razbot2/razbot2_nonros/razbot2_documentation/pictures/2014-11-12 20.54.26.jpg

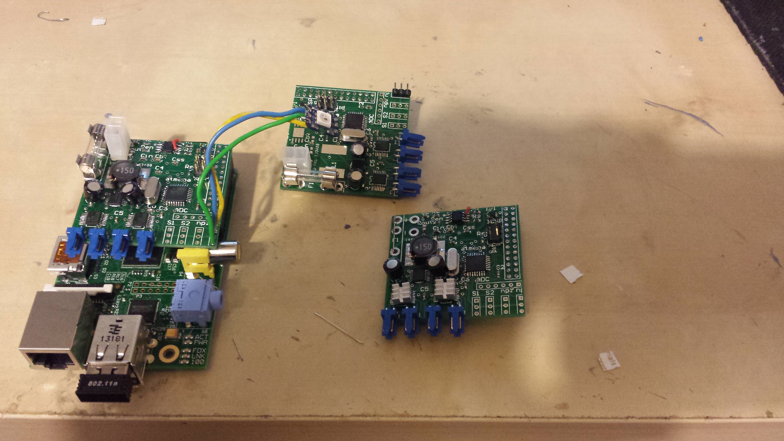
razbot2_documentation/pictures/2014-11-12 20.54.26.jpg
