razbot2/razbot2_nonros/razbot2_documentation/pictures/IMG_1996.JPG

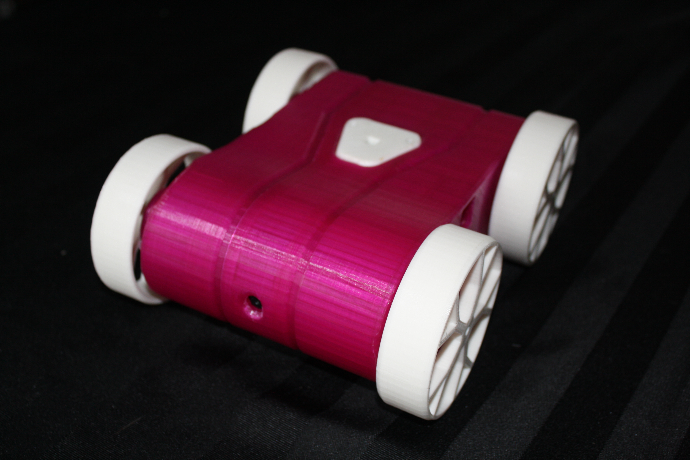
razbot2_documentation/pictures/IMG_1996.JPG
