razbot2/razbot2_nonros/razbot2_documentation/pictures/IMG_1997.JPG

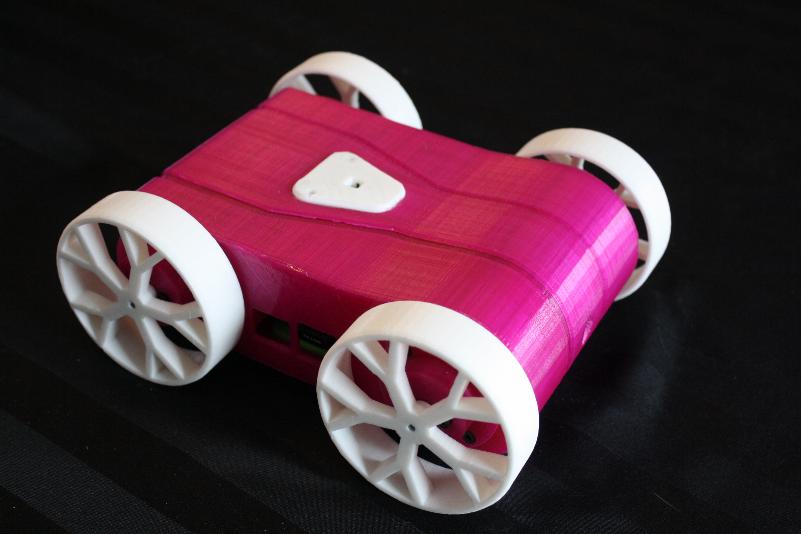
razbot2_documentation/pictures/IMG_1997.JPG
