razbot2/razbot2_nonros/razbot2_documentation/pictures/IMG_1998.JPG

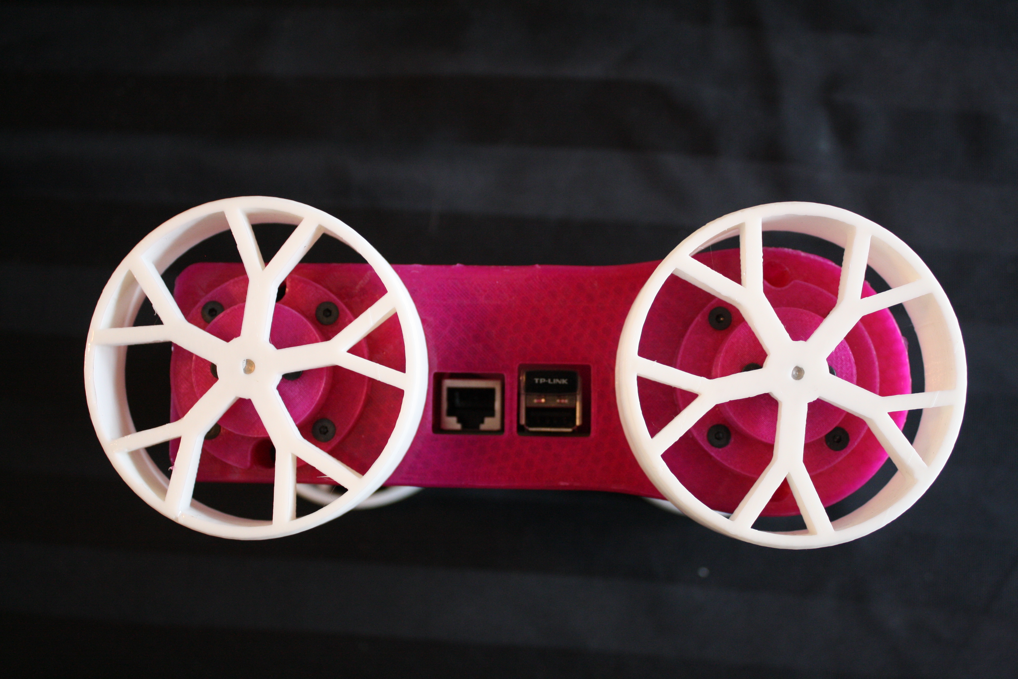
razbot2_documentation/pictures/IMG_1998.JPG
