razbot2/razbot2_nonros/razbot2_documentation/pictures/IMG_1999.JPG

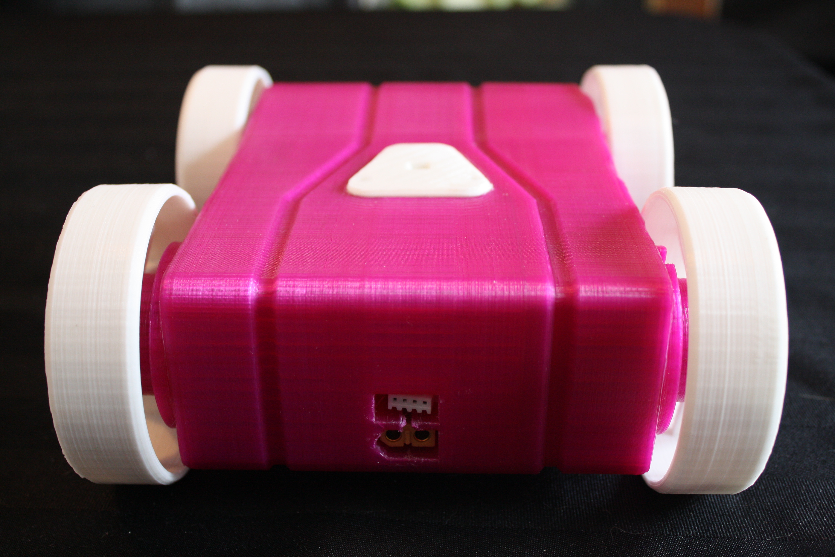
razbot2_documentation/pictures/IMG_1999.JPG
