razbot2/razbot2_nonros/razbot2_documentation/pictures/IMG_2000.JPG

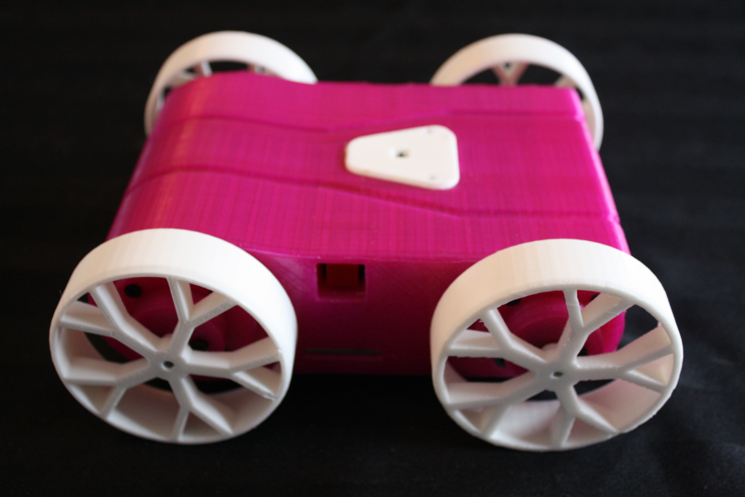
razbot2_documentation/pictures/IMG_2000.JPG
