razbot2/razbot2_nonros/razbot2_documentation/pictures/IMG_2001.JPG

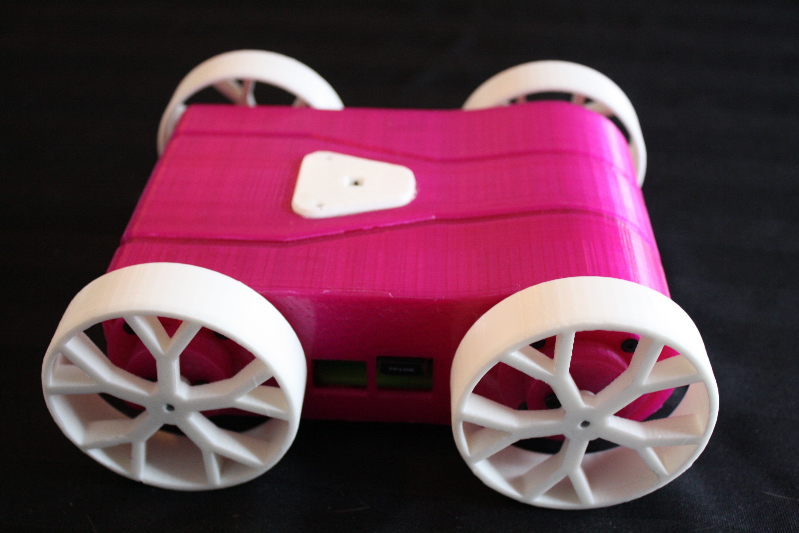
razbot2_documentation/pictures/IMG_2001.JPG
