razbot2/razbot2_nonros/razbot2_documentation/pictures/IMG_2508.JPG

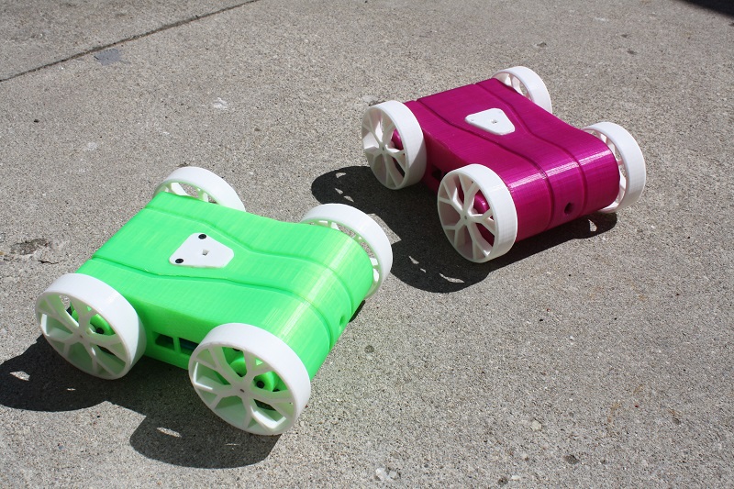
razbot2_documentation/pictures/IMG_2508.JPG
