razbot2/razbot2_nonros/razbot2_documentation/pictures/IMG_2514.JPG

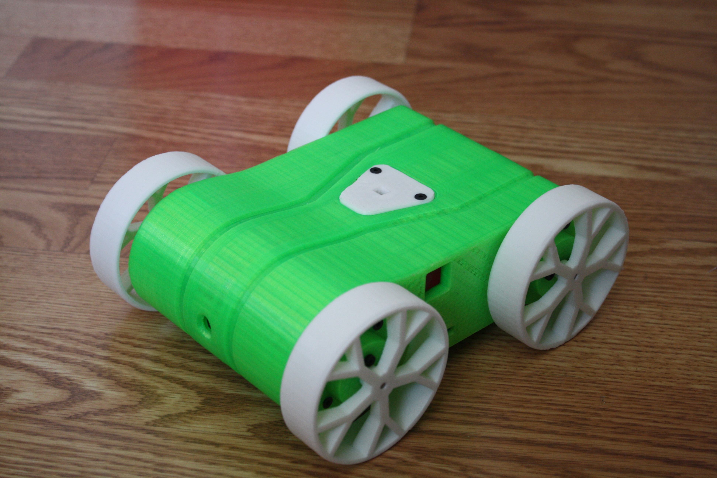
razbot2_documentation/pictures/IMG_2514.JPG
