razbot2/razbot2_nonros/razbot2_documentation/pictures/IMG_2879.JPG

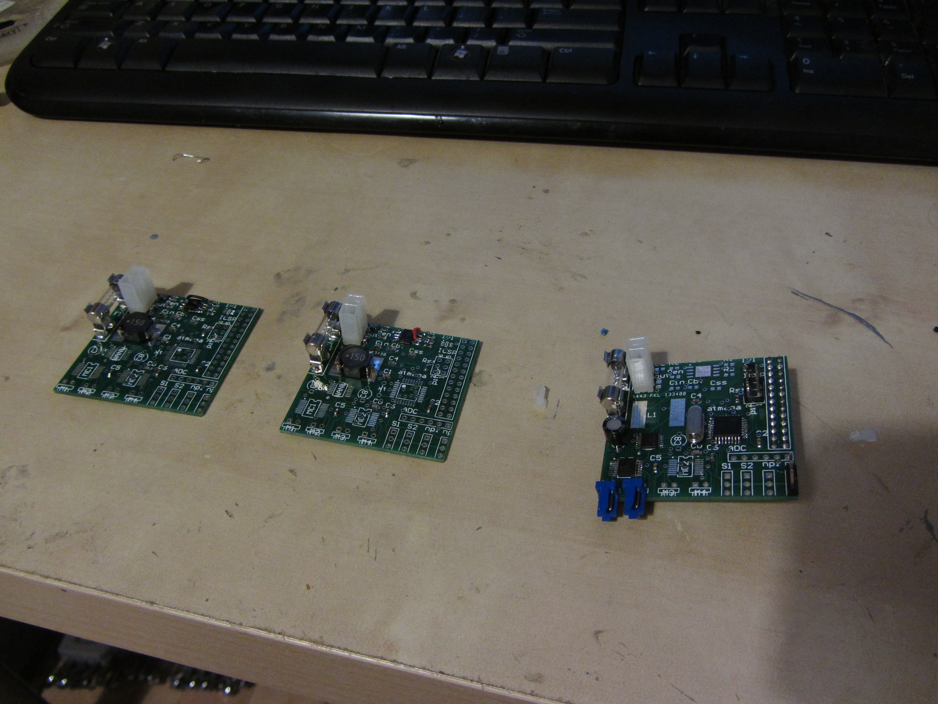
razbot2_documentation/pictures/IMG_2879.JPG
