razbot2/razbot2_nonros/razbot2_documentation/pictures/IMG_3035.JPG

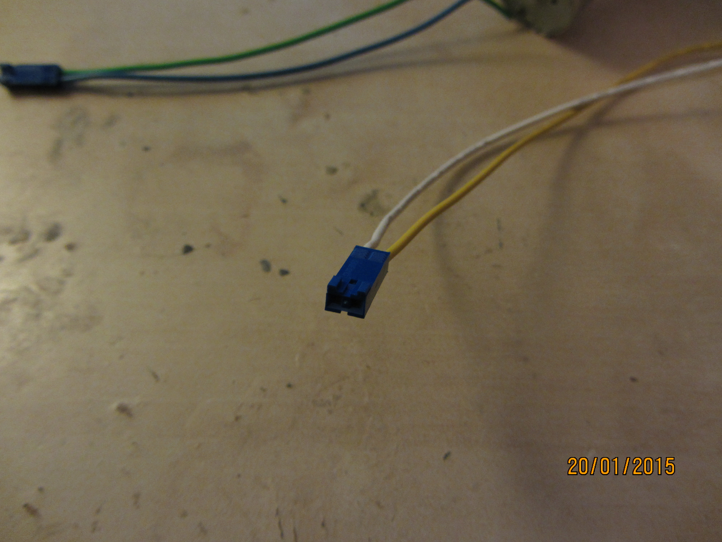
razbot2_documentation/pictures/IMG_3035.JPG
