razbot2/razbot2_nonros/razbot2_documentation/pictures/IMG_3036.JPG

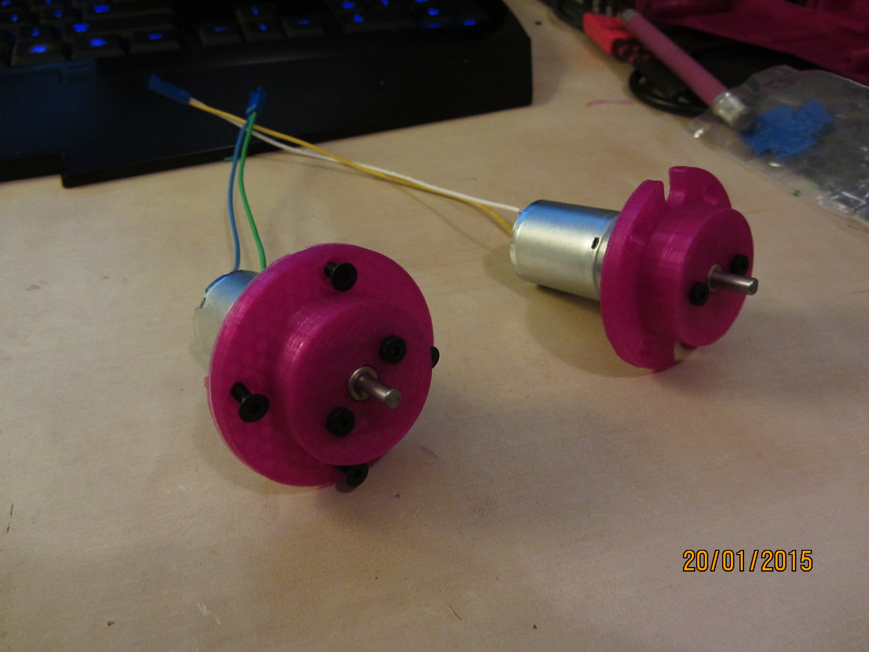
razbot2_documentation/pictures/IMG_3036.JPG
