razbot2/razbot2_nonros/razbot2_documentation/pictures/razbot3.jpg

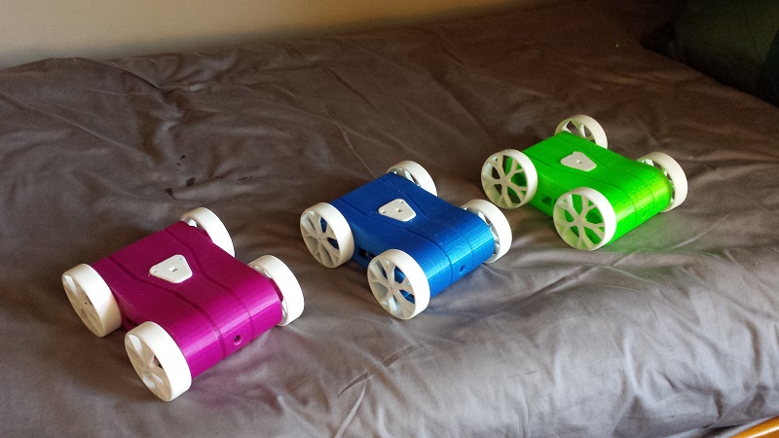
razbot2_documentation/pictures/razbot3.jpg
