razbot2/razbot2_nonros/razbot2_model/raspberry_pi_camera/RasPi_Camera.SLDASM

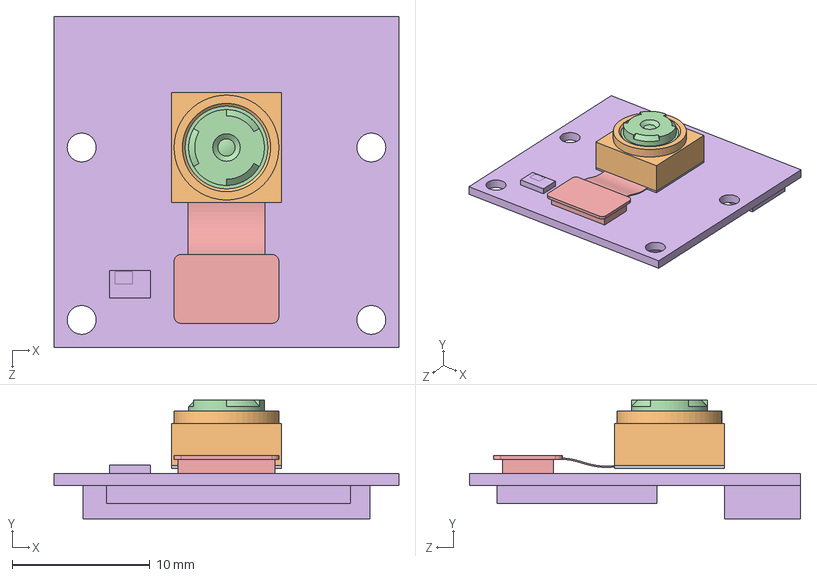
[picture p26: CAD file, 2015-10-27]
razbot2_model/raspberry_pi_camera/RasPi_Camera.SLDASM
25.0 x 8.60 x 24.0 mm
OVA5647
OVA5647_Housing
OVA5647_IR-Glas
OVA5647_Lens
OVA5647_Pigtail
RasPi_Camera_Board
