razbot2/razbot2_nonros/razbot2_model/raspberry_pi_camera/OVA5647.SLDASM

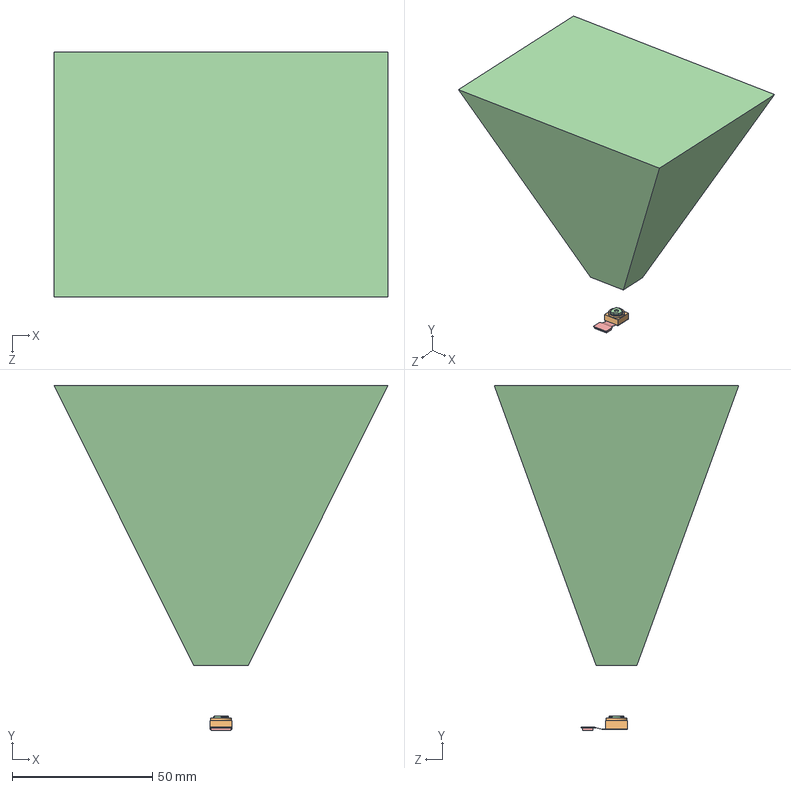
[picture p27: CAD file, 2015-10-27]
razbot2_model/raspberry_pi_camera/OVA5647.SLDASM
119.2 x 123.2 x 87.4 mm
OVA5647
OVA5647_Housing
OVA5647_IR-Glas
OVA5647_Lens
OVA5647_Pigtail
