razbot2/razbot2_nonros/razbot2_model/Side_Assem_Right.SLDASM

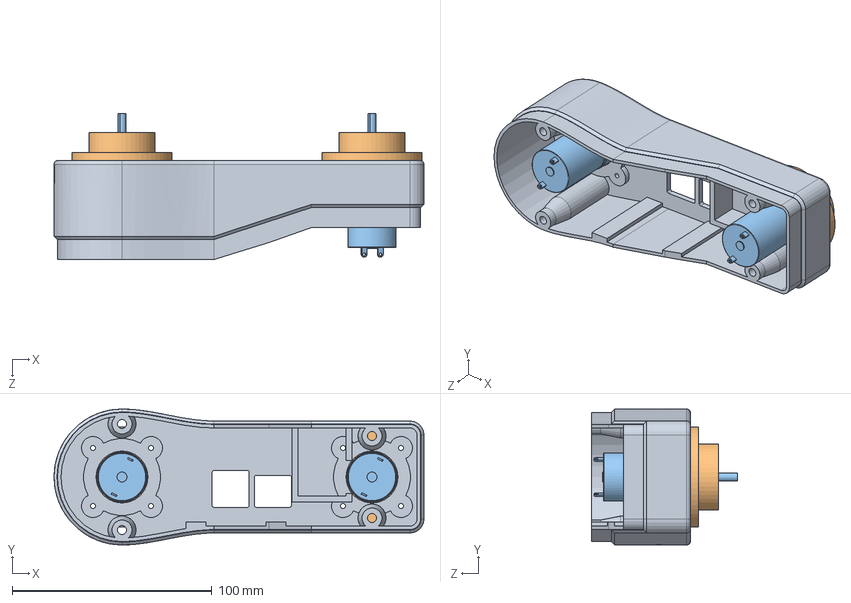
[picture p28: CAD file, 2015-10-27]
razbot2_model/Side_Assem_Right.SLDASM
185.0 x 68.0 x 73.0 mm
Side_Right
motor_holder_r0.4 x 2
Motor_25x55_gear x 2
