razbot2/razbot2_nonros/razbot2_model/Side_Assem_Left.SLDASM

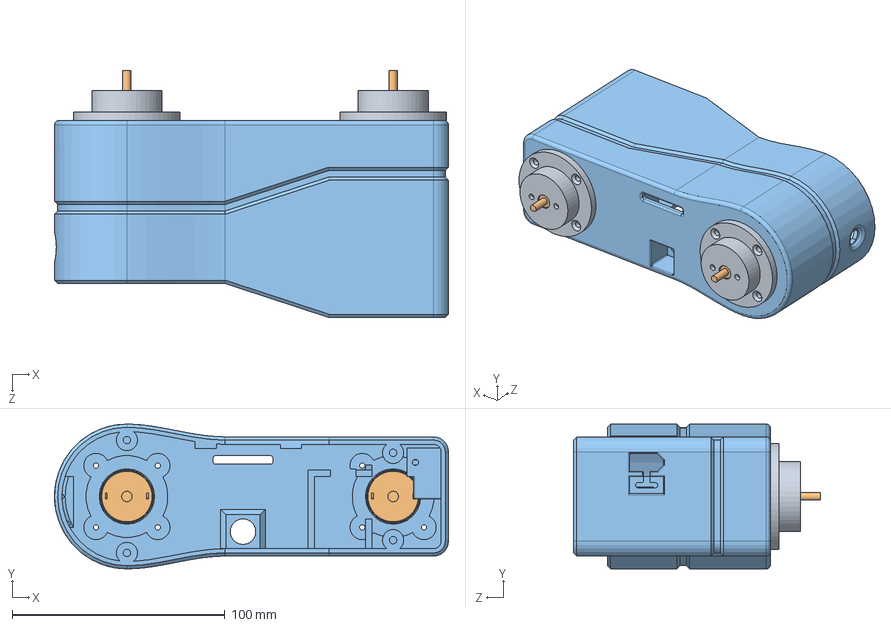
[picture p30: CAD file, 2015-10-27]
razbot2_model/Side_Assem_Left.SLDASM
185.0 x 68.0 x 116.0 mm
motor_holder_r0.4 x 2
Motor_25x55_gear x 2
Side_Left
