razbot2/razbot2_nonros/razbot2_model/Motor_Assem.SLDASM

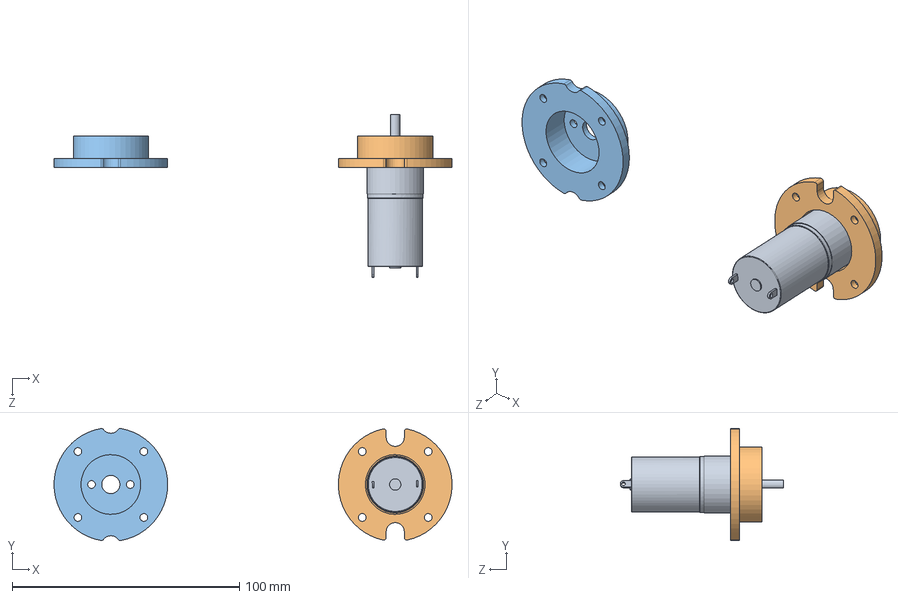
[picture p33: CAD file, 2015-10-27]
razbot2_model/Motor_Assem.SLDASM
175.0 x 49.3 x 71.9 mm
25x55_gear_motor
motor_holder_r0.5
