razbot2/razbot2_nonros/razbot2_model/raspberry_pi/raspberry_pi__micro_USB.SLDASM

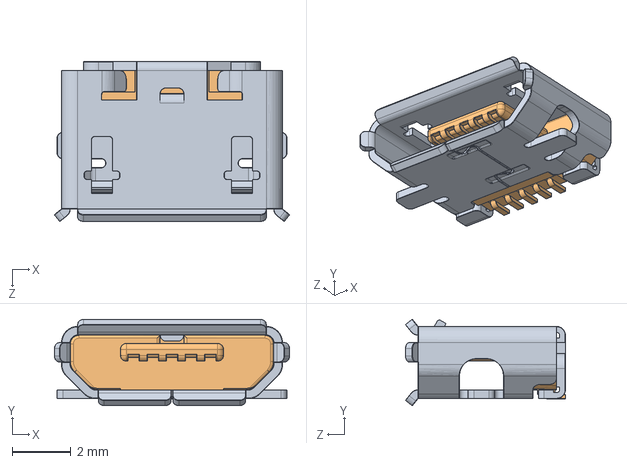
[picture p35: CAD file, 2015-10-27]
razbot2_model/raspberry_pi/raspberry_pi__micro_USB.SLDASM
7.97 x 2.92 x 5.43 mm
raspberry_pi__micro_USB_cover
raspberry_pi__micro_USB_contacts
