razbot2/razbot2_nonros/razbot2_model/raspberry_pi/raspberry_pi__USB_x2.SLDASM

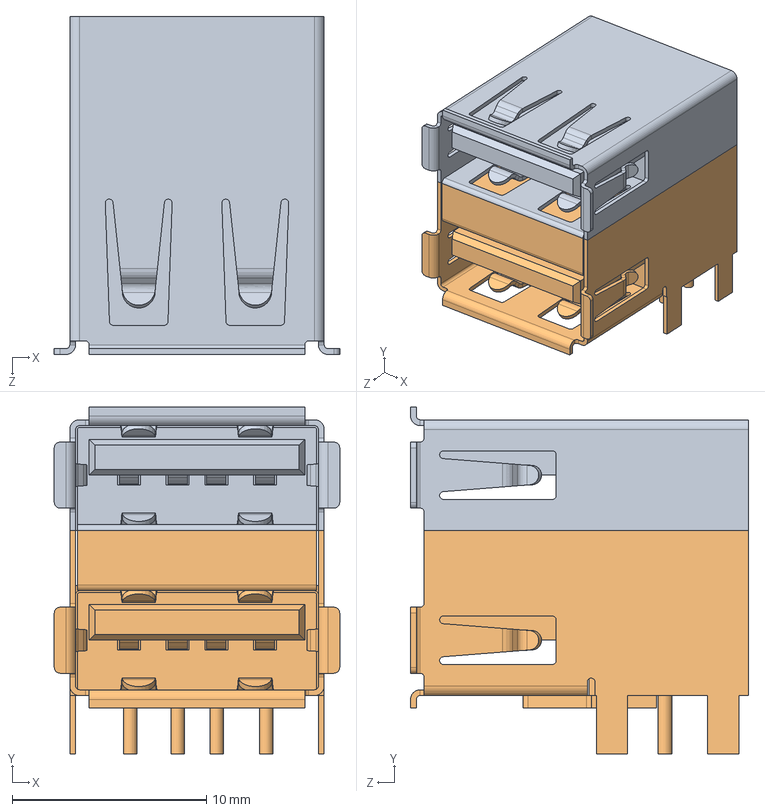
[picture p37: CAD file, 2015-10-27]
razbot2_model/raspberry_pi/raspberry_pi__USB_x2.SLDASM
14.7 x 17.9 x 17.4 mm
raspberry_pi__USB_x2_part1
raspberry_pi__USB_x2_part2
