razbot2/razbot2_nonros/razbot2_model/gazeboSTL/wheel_3.STL

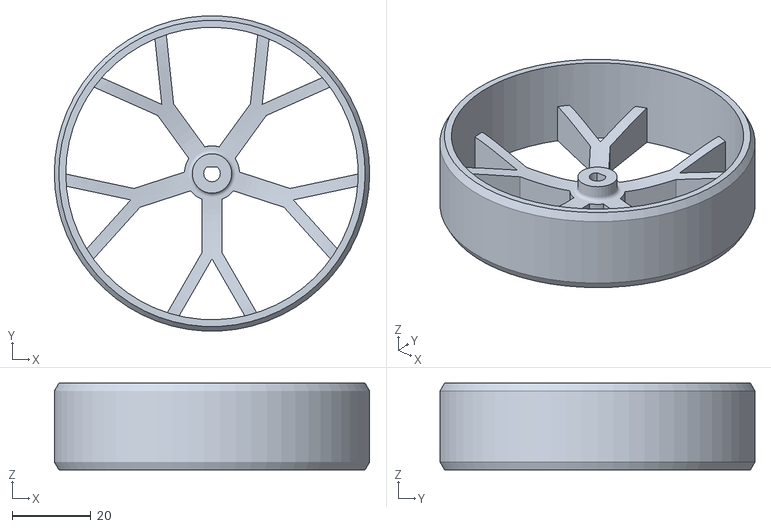
[picture p40: CAD file, 2015-10-27]
razbot2_model/gazeboSTL/wheel_3.STL
80.0 x 79.9 x 22.0
