razbot2/razbot2_nonros/razbot2_model/PiTrayB+.SLDPRT

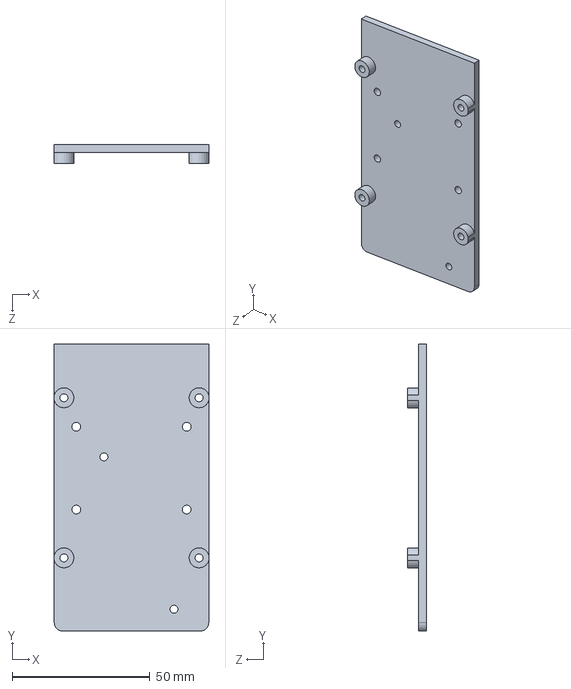
[picture p41: CAD file, 2015-10-27]
razbot2_model/PiTrayB+.SLDPRT
56.0 x 104.0 x 7.00 mm
