razbot2/razbot2_nonros/razbot2_model/raspberry_pi/raspberry_pi__QFN64-2.SLDPRT

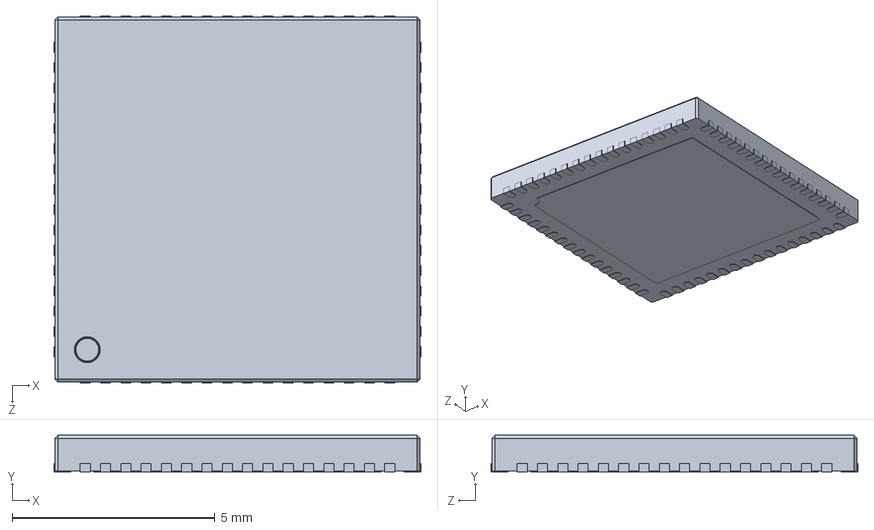
[picture p42: CAD file, 2015-10-27]
razbot2_model/raspberry_pi/raspberry_pi__QFN64-2.SLDPRT
9.04 x 0.9 x 9.04 mm
