razbot2/razbot2_nonros/razbot2_model/raspberry_pi_acc/USBwifi.SLDPRT

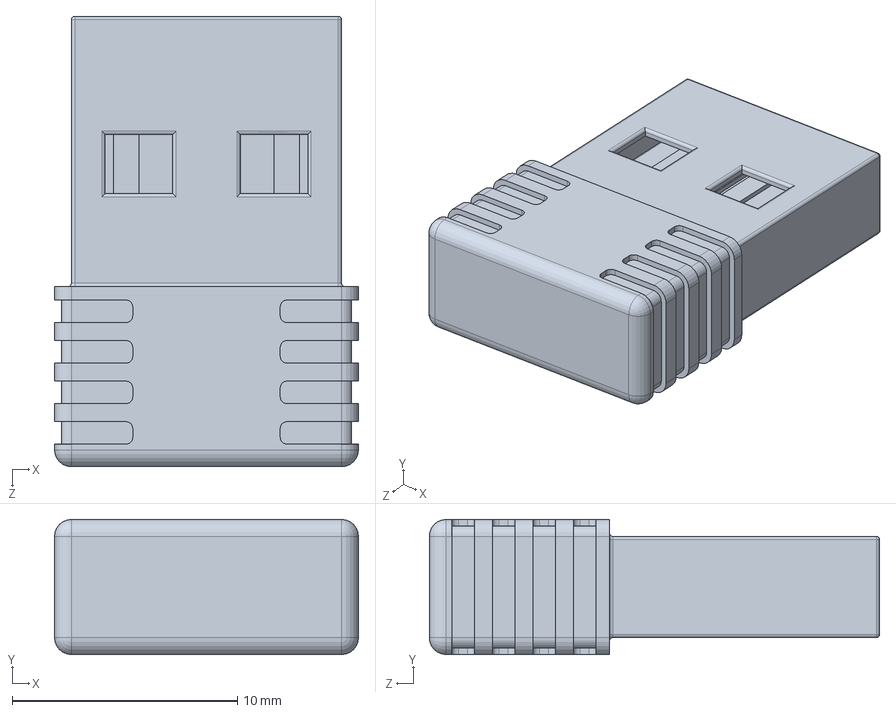
[picture p43: CAD file, 2015-10-27]
razbot2_model/raspberry_pi_acc/USBwifi.SLDPRT
13.5 x 6.00 x 20.0 mm
