razbot2/razbot2_nonros/razbot2_model/raspberry_pi_camera/OVA5647_Lens.SLDPRT

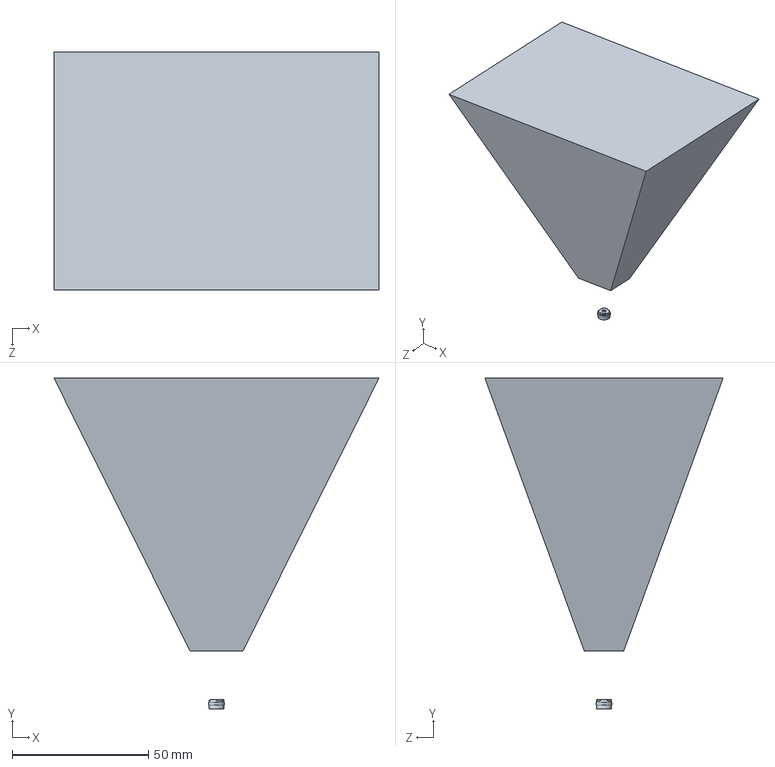
[picture p44: CAD file, 2015-10-27]
razbot2_model/raspberry_pi_camera/OVA5647_Lens.SLDPRT
119.2 x 121.3 x 87.4 mm
