razbot2/razbot2_nonros/razbot2_model/razbot2_mods/Razbot Mounting Plate.STL

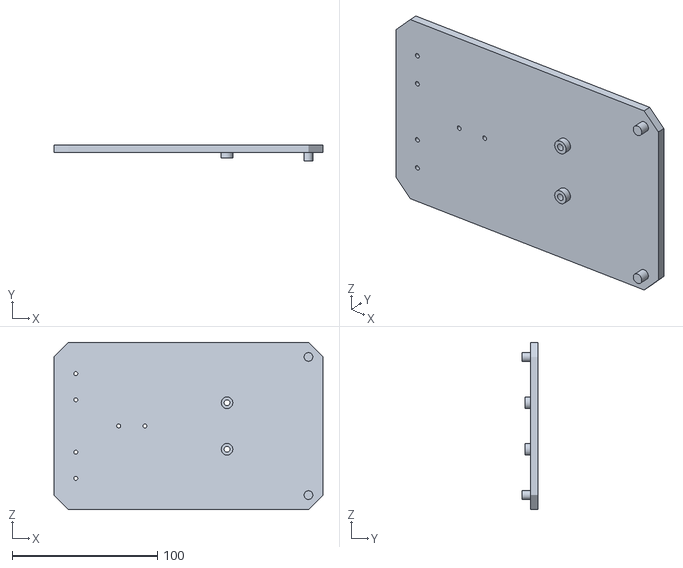
[picture p45: CAD file, 2015-12-04]
razbot2_model/razbot2_mods/Razbot Mounting Plate.STL
185.0 x 11.0 x 115.0
