razbot2/razbot2_nonros/razbot2_model/razbot_STL/Top_Plate.stl

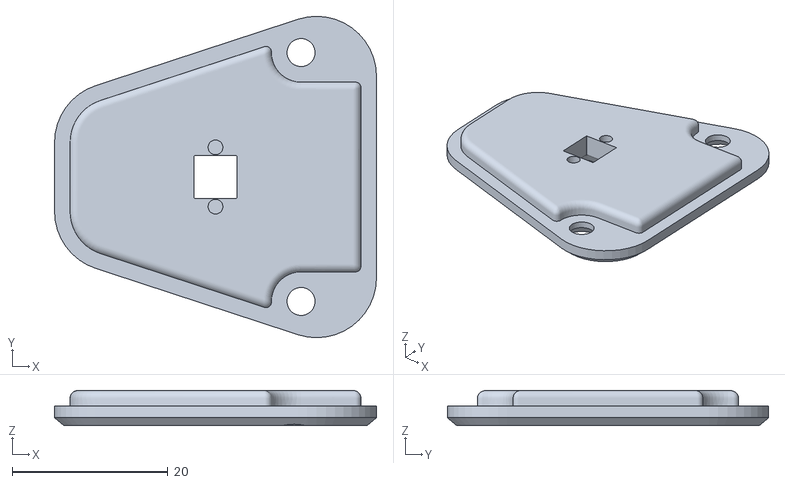
[picture p46: CAD file, 2015-10-27]
razbot2_model/razbot_STL/Top_Plate.stl
41.4 x 41.3 x 4.50
