razbot2/razbot2_nonros/razbot2_model/motor_holder_r0.5.SLDPRT

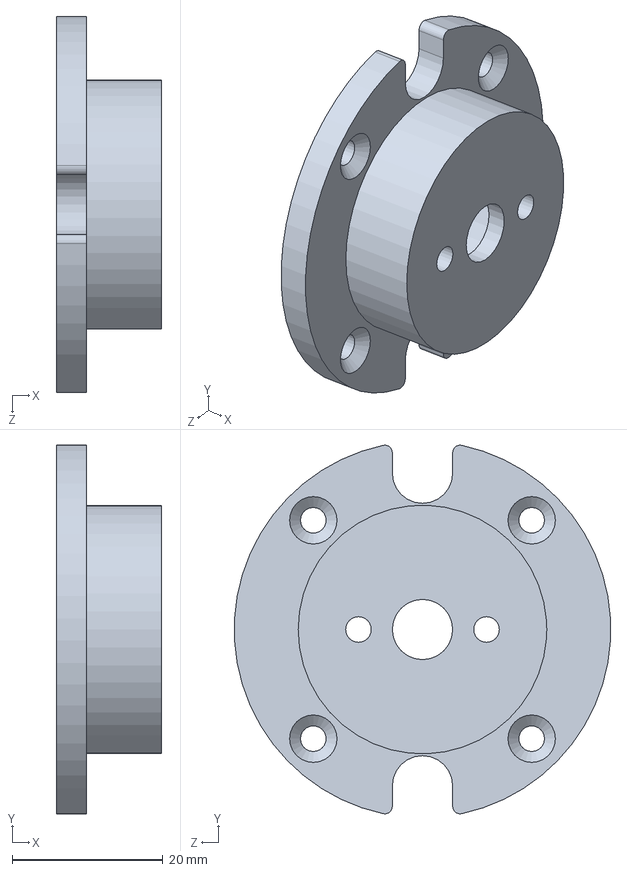
[picture p47: CAD file, 2015-10-27]
razbot2_model/motor_holder_r0.5.SLDPRT
14.0 x 48.9 x 49.9 mm
