razbot2/razbot2_nonros/razbot2_model/raspberry_pi/raspberry_pi__1812.SLDPRT

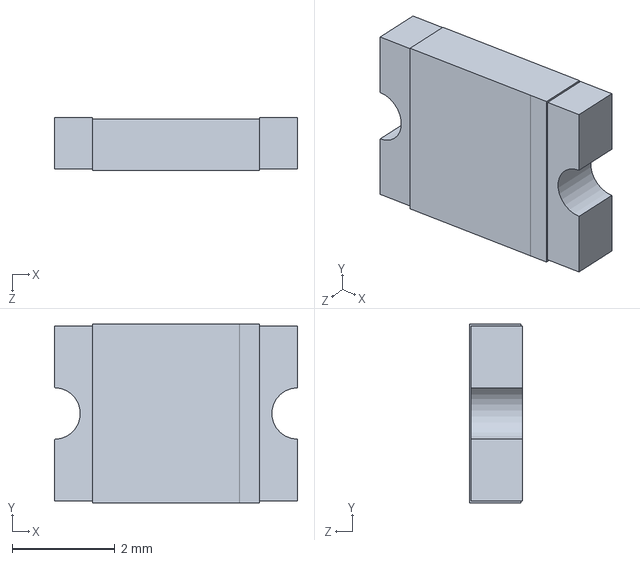
[picture p48: CAD file, 2015-10-27]
razbot2_model/raspberry_pi/raspberry_pi__1812.SLDPRT
4.74 x 3.48 x 1.03 mm
