razbot2/razbot2_nonros/razbot2_model/raspberry_pi_camera/OVA5647_IR-Glas.SLDPRT

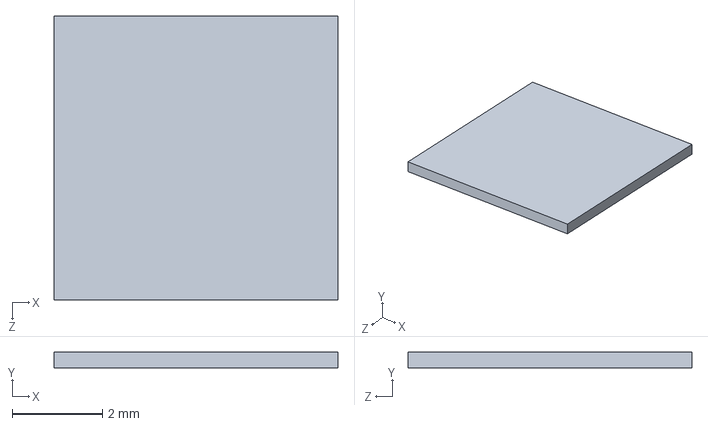
[picture p49: CAD file, 2015-10-27]
razbot2_model/raspberry_pi_camera/OVA5647_IR-Glas.SLDPRT
6.30 x 0.35 x 6.30 mm
