razbot2/razbot2_nonros/razbot2_model/razbot2_mods/GripperGear.stl

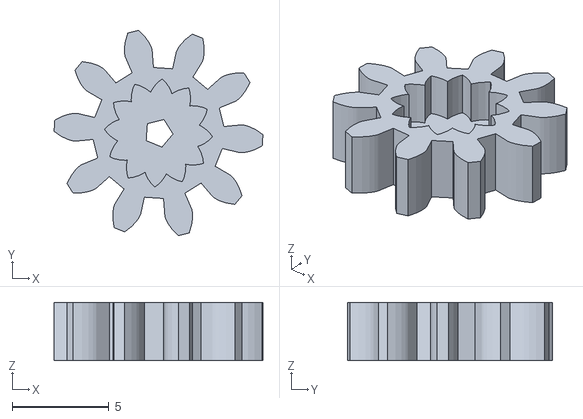
[picture p50: CAD file, 2015-12-04]
razbot2_model/razbot2_mods/GripperGear.stl
10.8 x 10.6 x 3.00
