razbot2/razbot2_nonros/razbot2_model/Motor_25x55_gear.SLDPRT

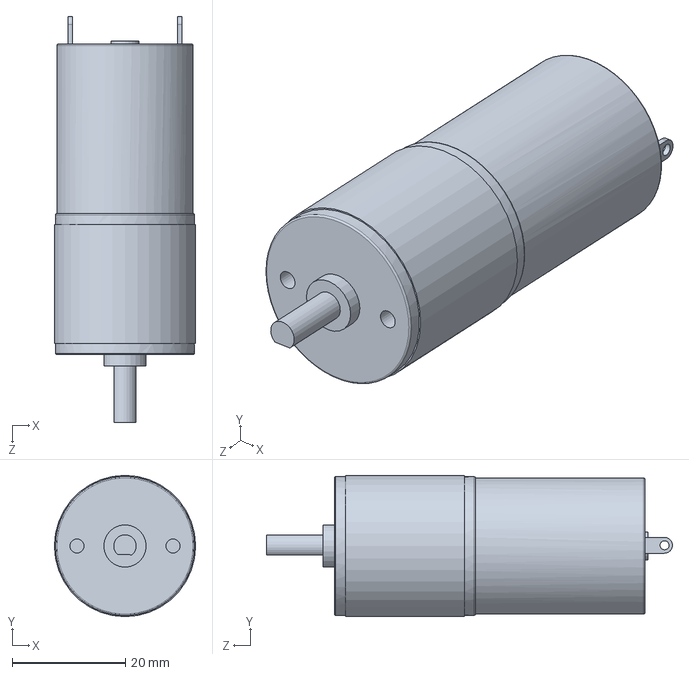
[picture p51: CAD file, 2015-10-27]
razbot2_model/Motor_25x55_gear.SLDPRT
25.0 x 25.0 x 71.9 mm
