razbot2/razbot2_nonros/razbot2_model/raspberry_pi/raspberry_pi__SD_reader_pin4.SLDPRT

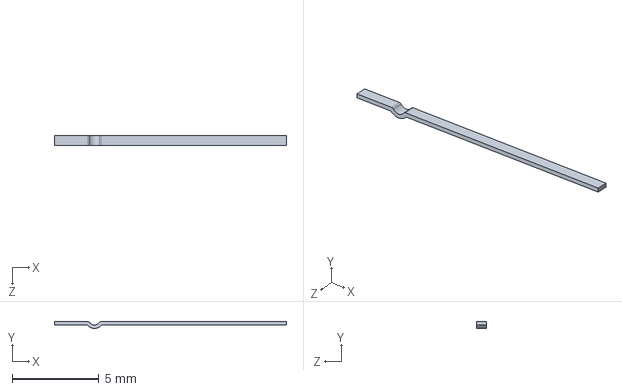
[picture p52: CAD file, 2015-10-27]
razbot2_model/raspberry_pi/raspberry_pi__SD_reader_pin4.SLDPRT
13.3 x 0.396 x 0.55 mm
