razbot2/razbot2_nonros/razbot2_model/razbot2_mods/Razbot_2 Arm Base.STL

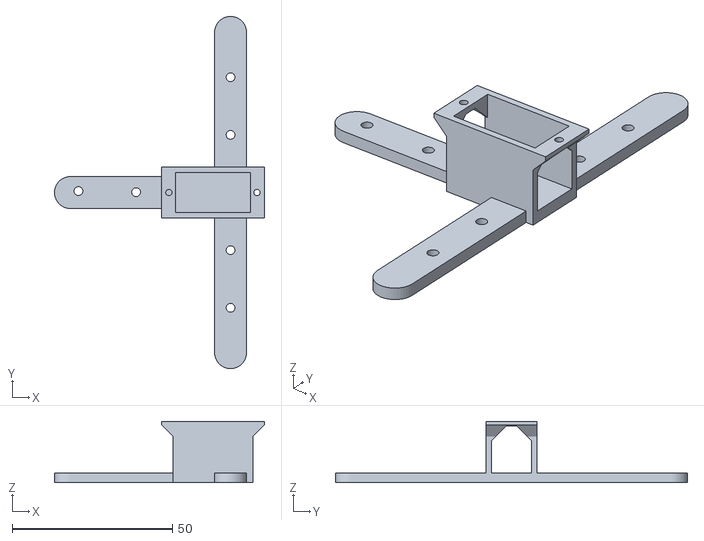
[picture p53: CAD file, 2015-12-04]
razbot2_model/razbot2_mods/Razbot_2 Arm Base.STL
65.6 x 110.0 x 19.2
