razbot2/razbot2_nonros/razbot2_model/razbot_STL/L_motor_holder.STL

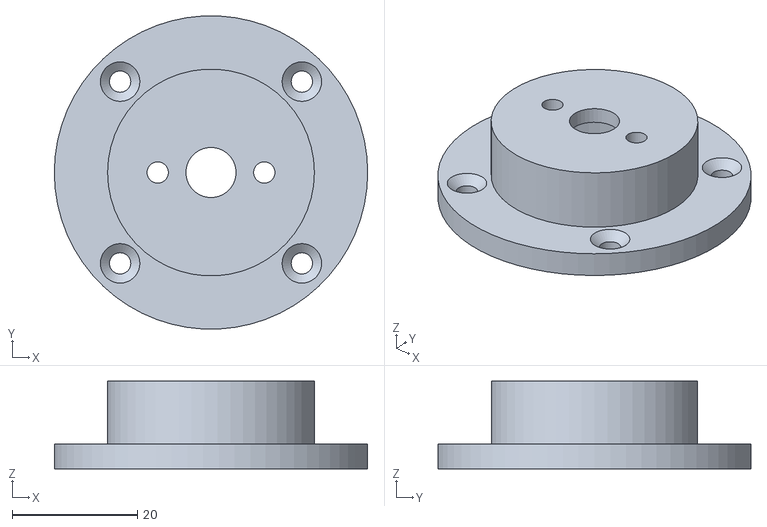
[picture p54: CAD file, 2015-10-27]
razbot2_model/razbot_STL/L_motor_holder.STL
50.0 x 49.9 x 14.0
