razbot2/razbot2_nonros/razbot2_model/raspberry_pi/raspberry_pi__15_pin_FFC_Connector_pins.SLDPRT

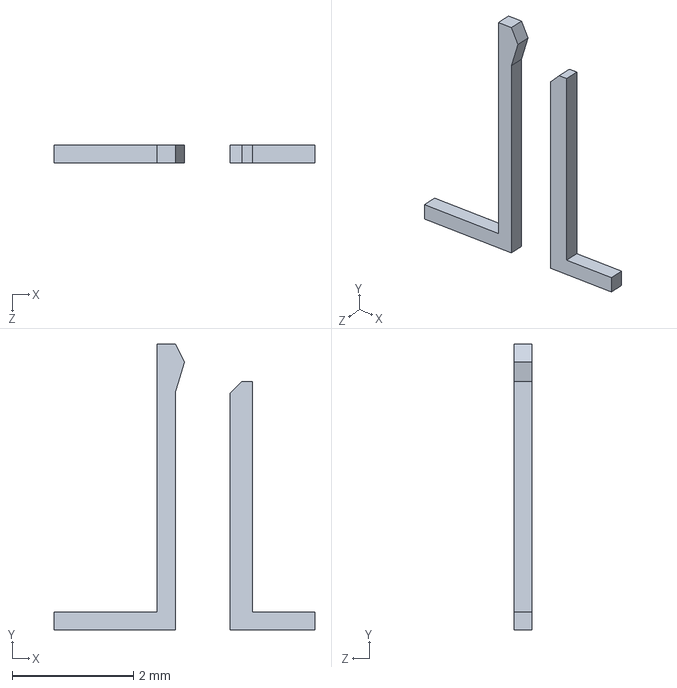
[picture p55: CAD file, 2015-10-27]
razbot2_model/raspberry_pi/raspberry_pi__15_pin_FFC_Connector_pins.SLDPRT
4.30 x 4.71 x 0.3 mm
