razbot2/razbot2_nonros/razbot2_model/razbot2_mods/ArmSpring.stl

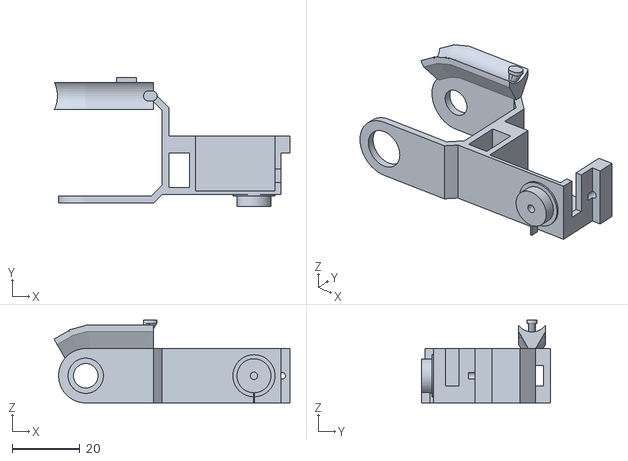
[picture p56: CAD file, 2015-12-04]
razbot2_model/razbot2_mods/ArmSpring.stl
69.4 x 37.9 x 24.4
