razbot2/razbot2_nonros/razbot2_model/raspberry_pi/raspberry_pi__HDMI_socket_small_pin.SLDPRT

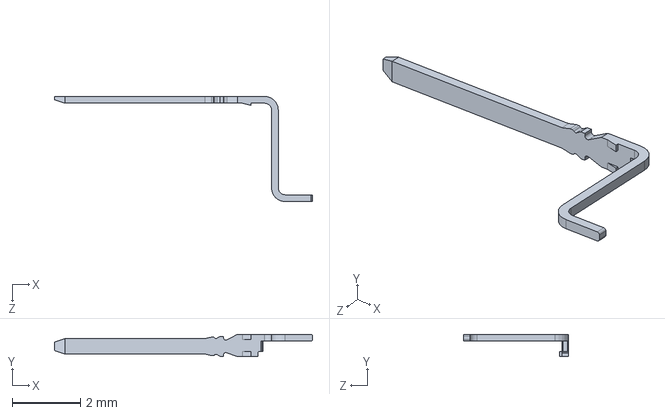
[picture p58: CAD file, 2015-10-27]
razbot2_model/raspberry_pi/raspberry_pi__HDMI_socket_small_pin.SLDPRT
7.55 x 0.65 x 3.08 mm
