razbot2/razbot2_nonros/razbot2_model/raspberry_pi_camera/RasPi_Camera_Board.SLDPRT

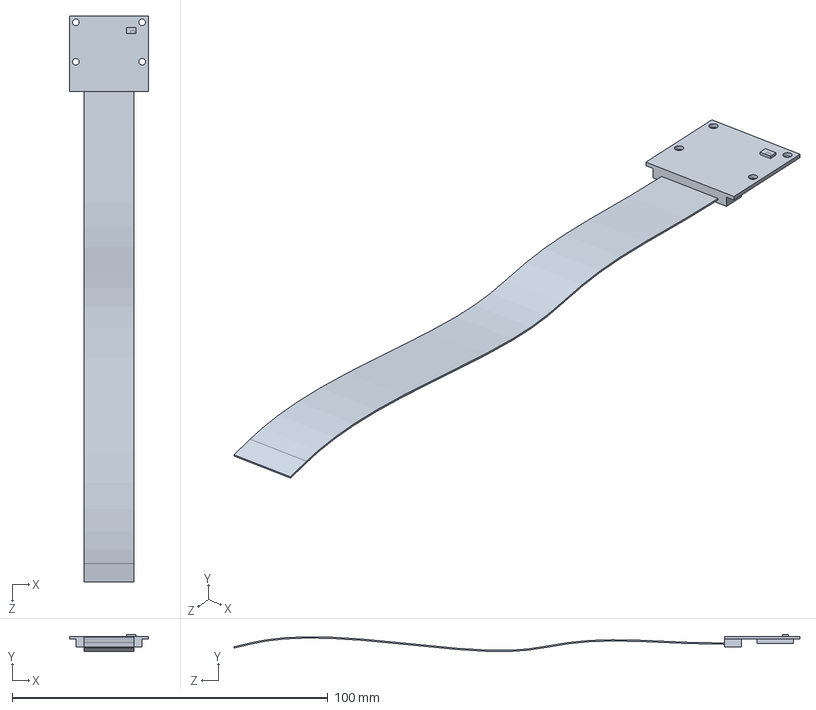
[picture p59: CAD file, 2015-10-27]
razbot2_model/raspberry_pi_camera/RasPi_Camera_Board.SLDPRT
25.0 x 5.39 x 179.3 mm
