razbot2/razbot2_nonros/razbot2_model/razbot2_mods/FrontPlate.stl

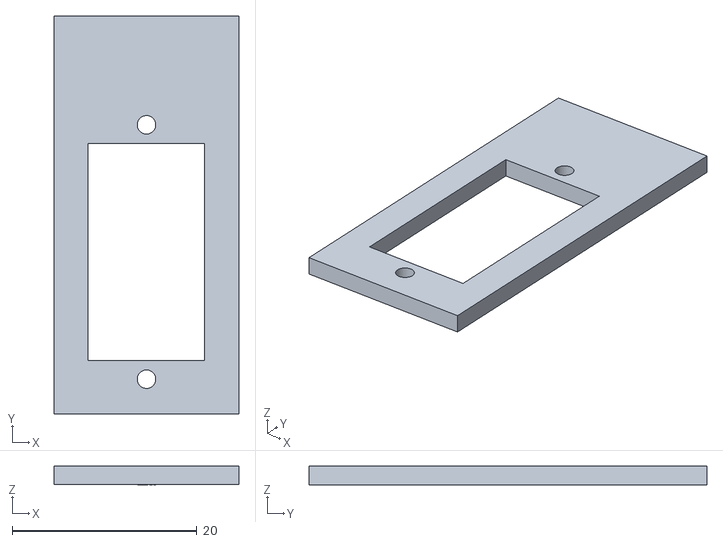
[picture p60: CAD file, 2015-12-04]
razbot2_model/razbot2_mods/FrontPlate.stl
20.0 x 43.0 x 2.00
