razbot2/razbot2_nonros/razbot2_model/razbot_STL/Side_Right_V01.stl

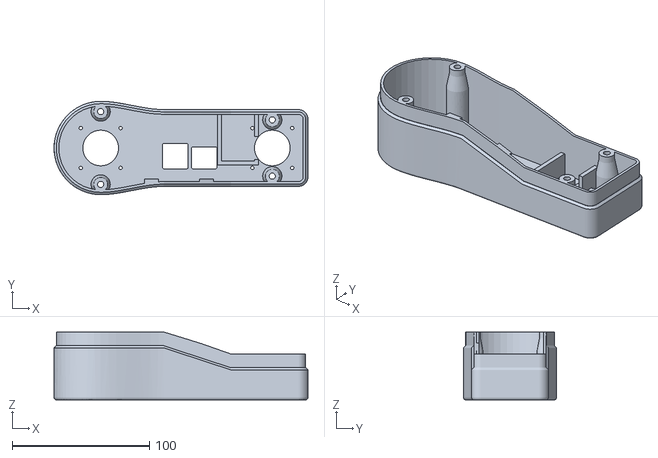
[picture p61: CAD file, 2015-10-27]
razbot2_model/razbot_STL/Side_Right_V01.stl
185.0 x 68.0 x 49.5
