razbot2/razbot2_nonros/razbot2_model/raspberry_pi/raspberry_pi__diode_10_pins.SLDPRT

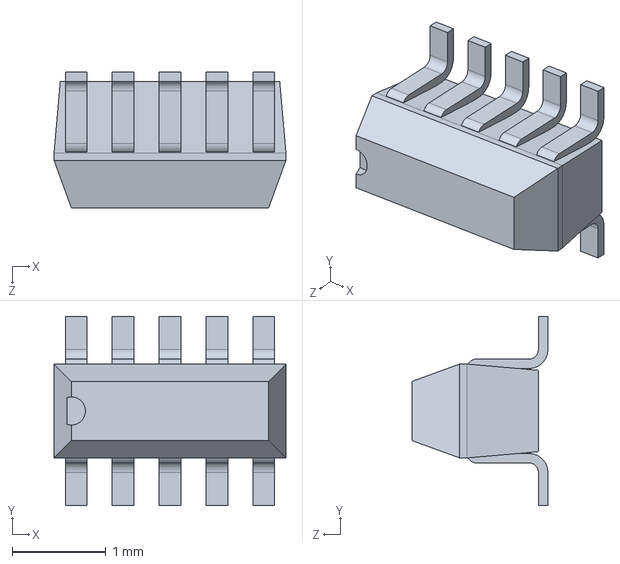
[picture p62: CAD file, 2015-10-27]
razbot2_model/raspberry_pi/raspberry_pi__diode_10_pins.SLDPRT
2.47 x 2.02 x 1.45 mm
