razbot2/razbot2_nonros/razbot2_model/razbot2_mods/Arm.stl

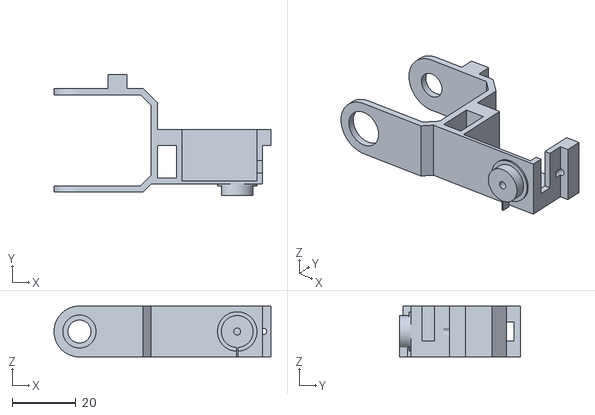
[picture p63: CAD file, 2015-12-04]
razbot2_model/razbot2_mods/Arm.stl
68.1 x 37.9 x 16.0
