razbot2/razbot2_nonros/razbot2_model/raspberry_pi/raspberry_pi__HDMI_socket_cover.SLDPRT

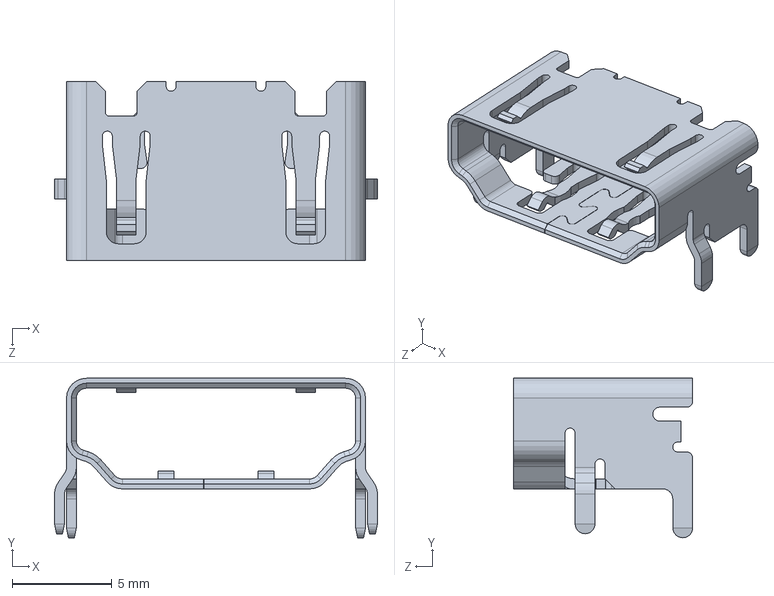
[picture p64: CAD file, 2015-10-27]
razbot2_model/raspberry_pi/raspberry_pi__HDMI_socket_cover.SLDPRT
16.2 x 8.00 x 9.00 mm
