razbot2/razbot2_nonros/razbot2_model/razbot2_mods/Swing.stl

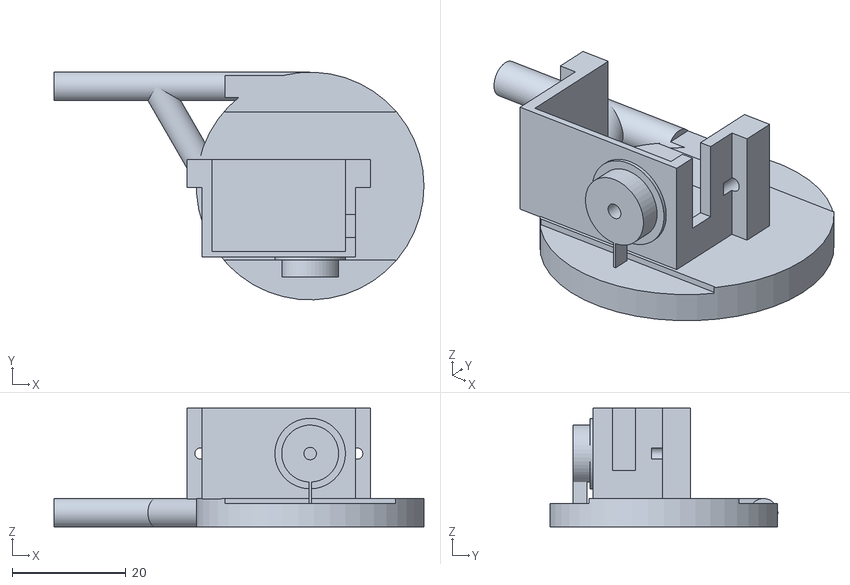
[picture p65: CAD file, 2015-12-04]
razbot2_model/razbot2_mods/Swing.stl
65.0 x 40.0 x 20.9
