razbot2/razbot2_nonros/razbot2_model/switch_pwr.SLDPRT

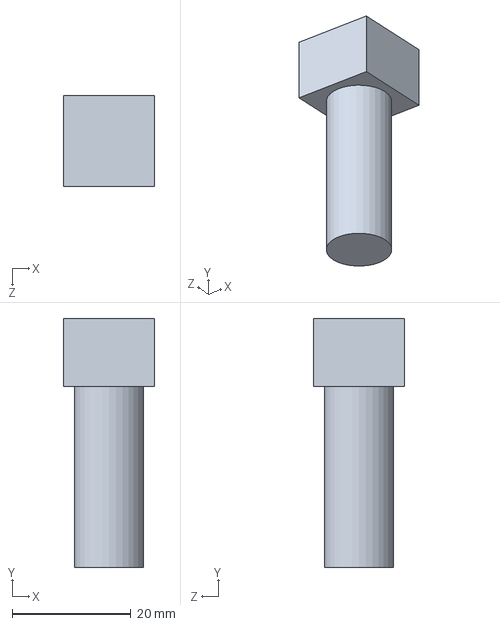
[picture p66: CAD file, 2015-10-27]
razbot2_model/switch_pwr.SLDPRT
15.2 x 41.9 x 15.2 mm
