razbot2/razbot2_nonros/razbot2_model/fake_pi_shield.SLDPRT

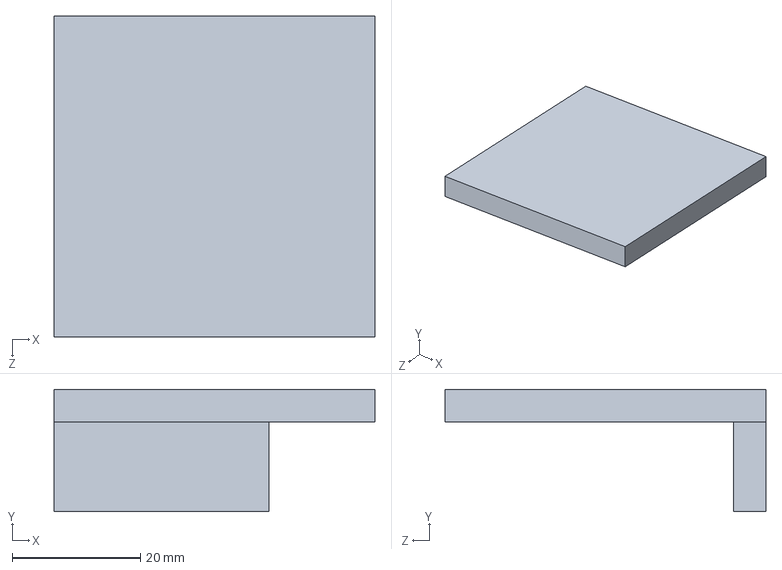
[picture p67: CAD file, 2015-10-27]
razbot2_model/fake_pi_shield.SLDPRT
50.0 x 19.1 x 50.0 mm
