razbot2/razbot2_nonros/razbot2_model/raspberry_pi/raspberry_pi__audio_out.SLDPRT

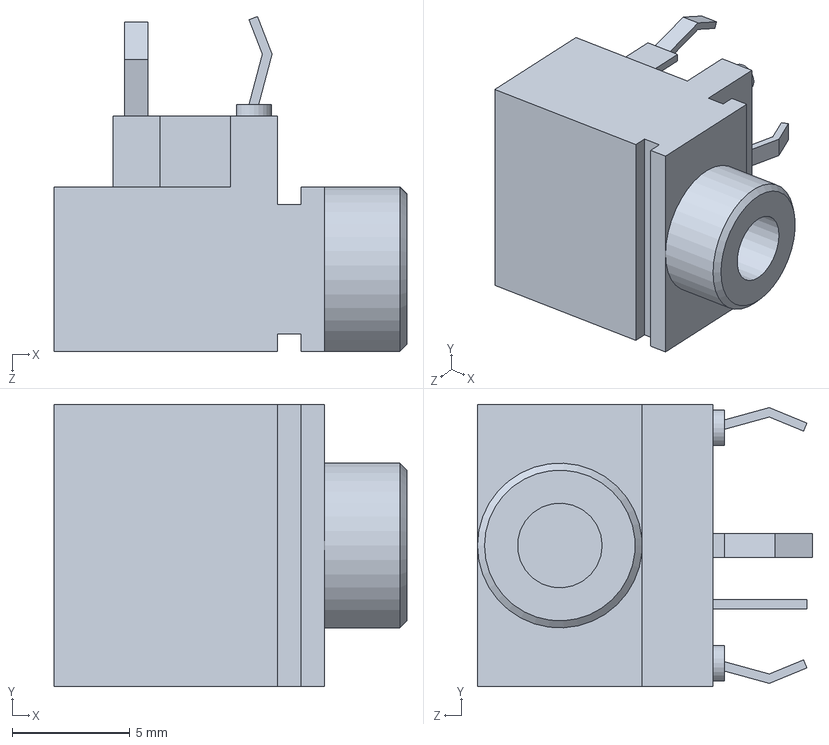
[picture p68: CAD file, 2015-10-27]
razbot2_model/raspberry_pi/raspberry_pi__audio_out.SLDPRT
15.0 x 12.0 x 14.2 mm
