razbot2/razbot2_nonros/razbot2_model/razbot2_mods/ArmFront.stl

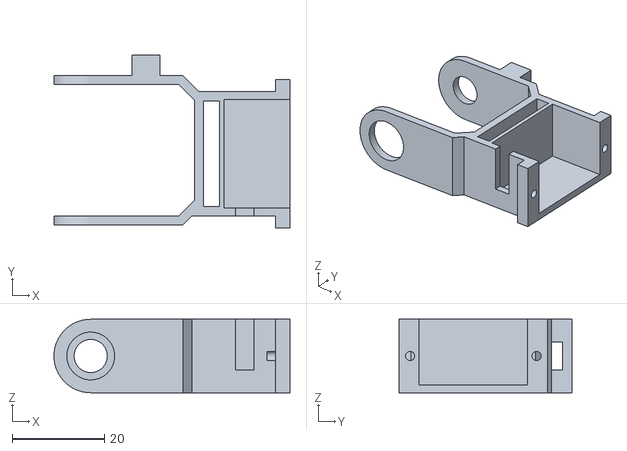
[picture p69: CAD file, 2015-12-04]
razbot2_model/razbot2_mods/ArmFront.stl
51.3 x 37.5 x 16.0
