razbot2/razbot2_nonros/razbot2_model/razbot_STL/FR_motor_holder.STL

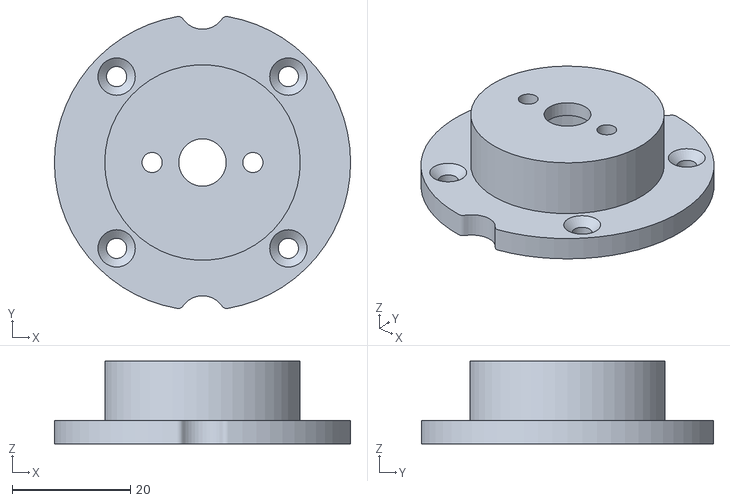
[picture p70: CAD file, 2015-10-27]
razbot2_model/razbot_STL/FR_motor_holder.STL
50.0 x 49.3 x 14.0
