razbot2/razbot2_nonros/razbot2_model/raspberry_pi/raspberry_pi__micro_USB_contacts.SLDPRT

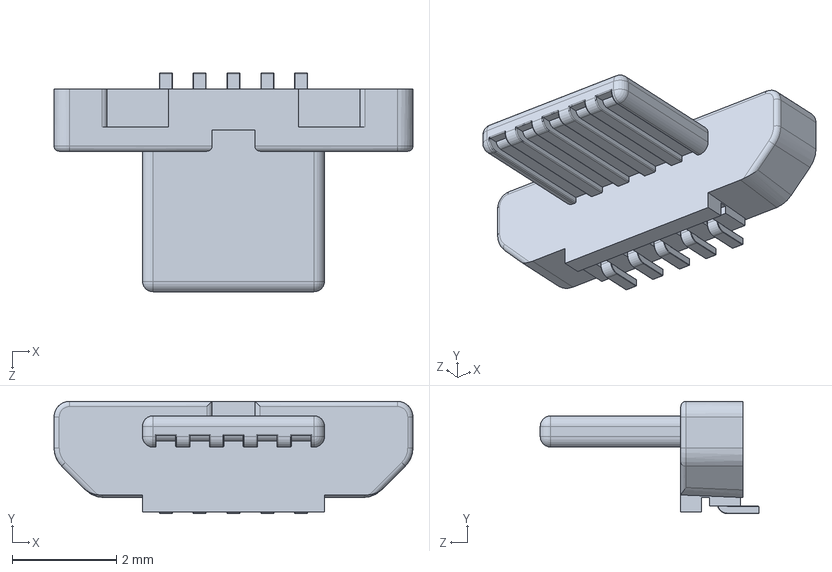
[picture p71: CAD file, 2015-10-27]
razbot2_model/raspberry_pi/raspberry_pi__micro_USB_contacts.SLDPRT
6.90 x 2.16 x 4.20 mm
