razbot2/razbot2_nonros/razbot2_model/razbot2_mods/Foot.stl

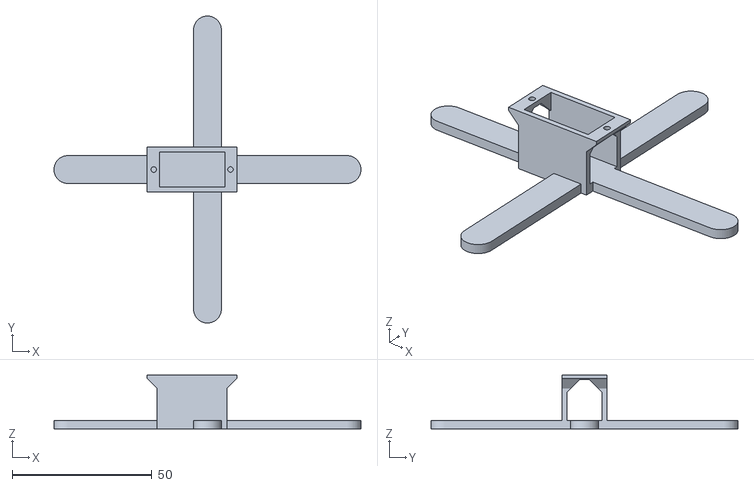
[picture p72: CAD file, 2015-12-04]
razbot2_model/razbot2_mods/Foot.stl
110.0 x 110.0 x 19.2
