razbot2/razbot2_nonros/razbot2_model/Side_Left.SLDPRT

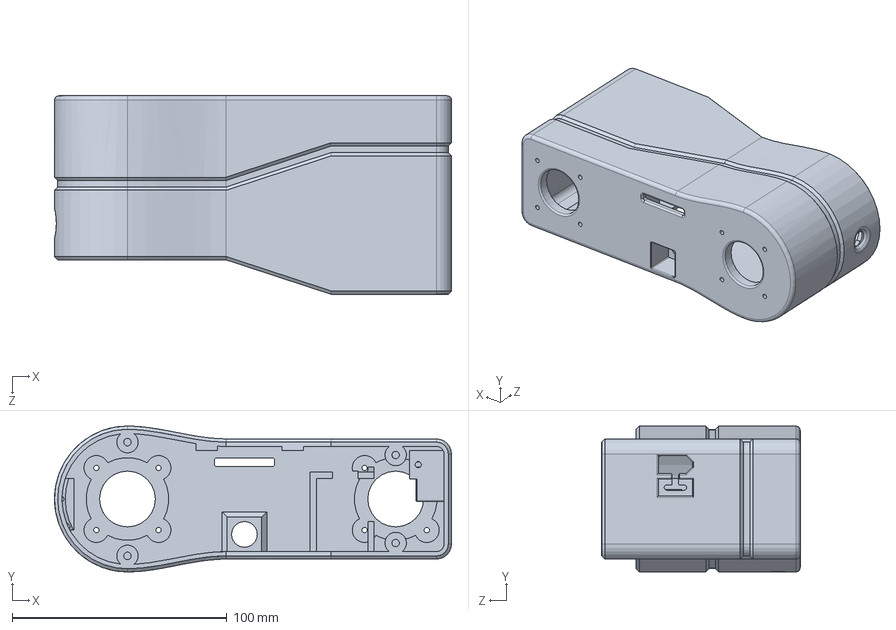
[picture p73: CAD file, 2015-10-27]
razbot2_model/Side_Left.SLDPRT
185.0 x 68.0 x 92.5 mm
