razbot2/razbot2_nonros/razbot2_model/raspberry_pi/raspberry_pi__1210.SLDPRT

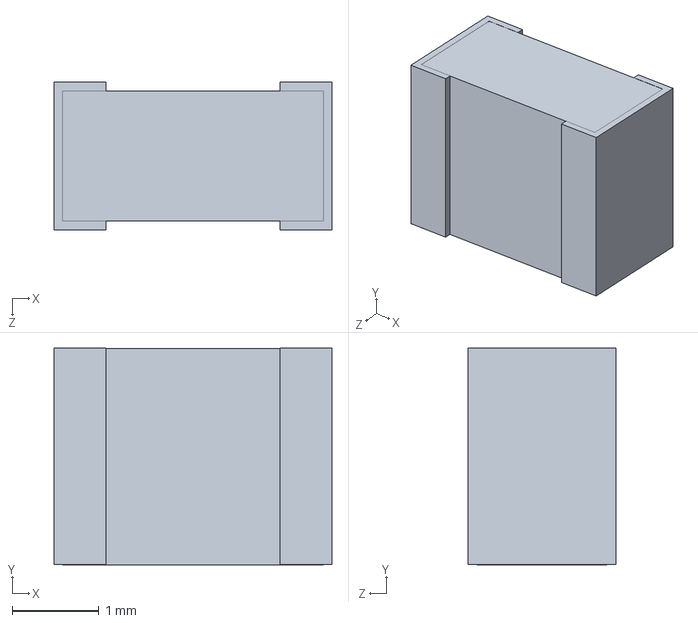
[picture p74: CAD file, 2015-10-27]
razbot2_model/raspberry_pi/raspberry_pi__1210.SLDPRT
3.20 x 2.49 x 1.70 mm
