razbot2/razbot2_nonros/razbot2_model/razbot2_mods/Gripper.stl

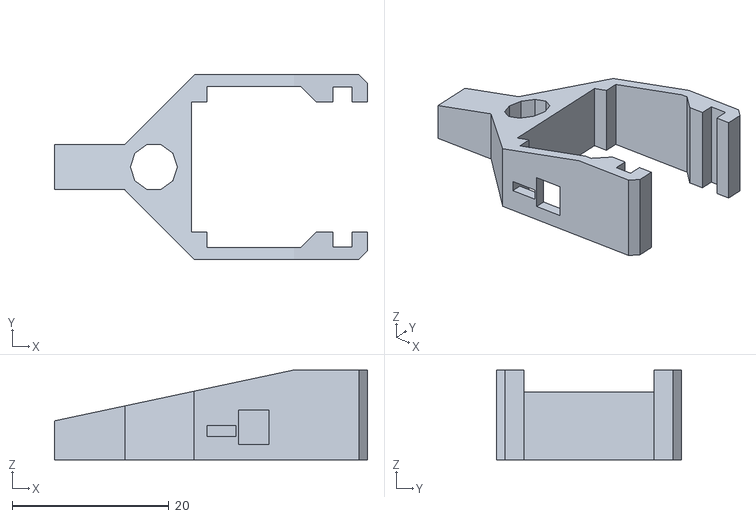
[picture p75: CAD file, 2015-12-04]
razbot2_model/razbot2_mods/Gripper.stl
40.0 x 23.6 x 11.5
