razbot2/razbot2_nonros/razbot2_model/Side_Right.SLDPRT

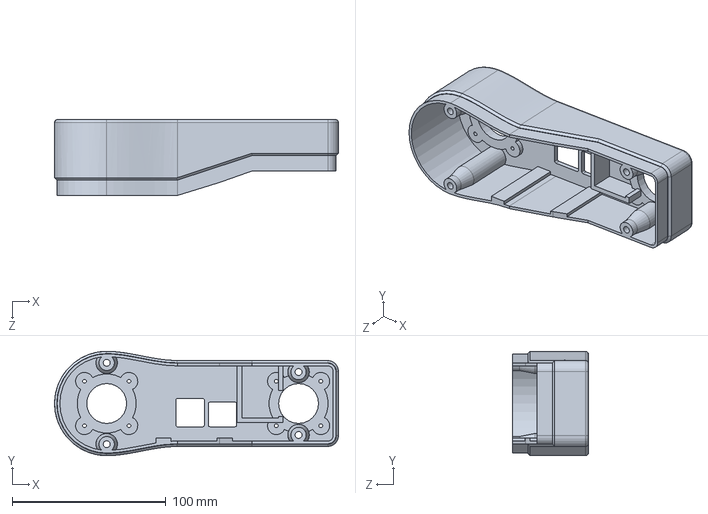
[picture p76: CAD file, 2015-10-27]
razbot2_model/Side_Right.SLDPRT
185.0 x 68.0 x 49.5 mm
