razbot2/razbot2_nonros/razbot2_model/raspberry_pi/raspberry_pi__LED_SMD_0603.SLDPRT

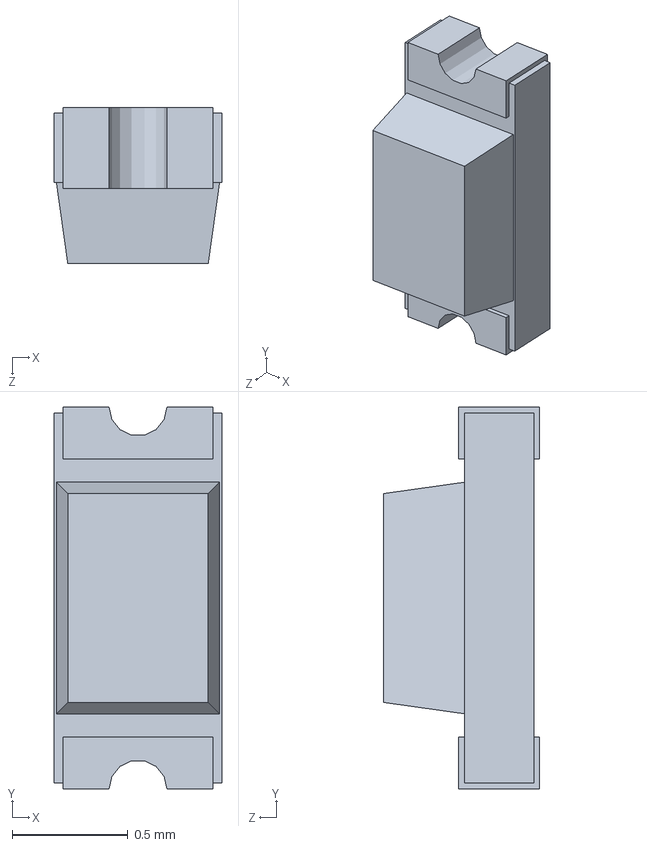
[picture p77: CAD file, 2015-10-27]
razbot2_model/raspberry_pi/raspberry_pi__LED_SMD_0603.SLDPRT
0.725 x 1.65 x 0.675 mm
