razbot2/razbot2_nonros/razbot2_model/razbot2_mods/GripperRack.stl

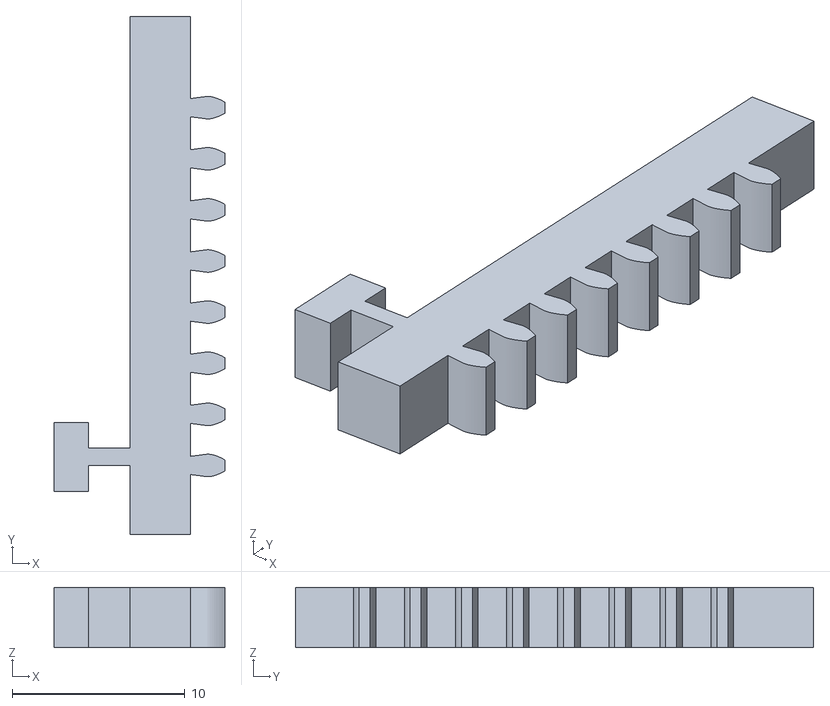
[picture p78: CAD file, 2015-12-04]
razbot2_model/razbot2_mods/GripperRack.stl
9.89 x 30.0 x 3.50
