razbot2/razbot2_nonros/razbot2_model/3S2200mAhLIPO.SLDPRT

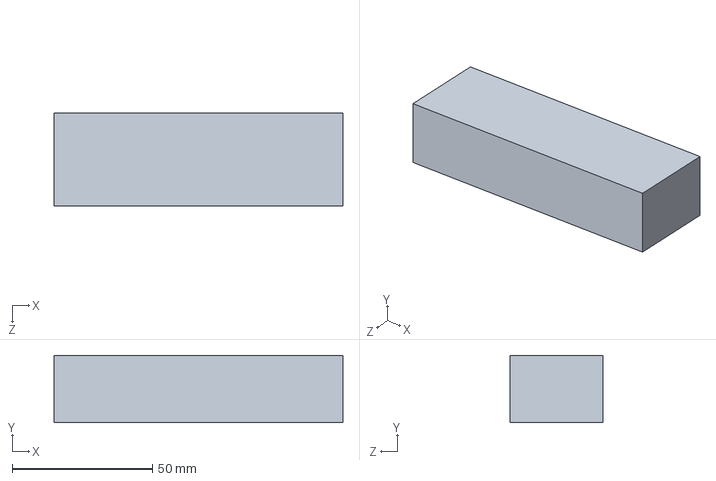
[picture p79: CAD file, 2015-10-27]
razbot2_model/3S2200mAhLIPO.SLDPRT
103.0 x 24.0 x 33.0 mm
