razbot2/razbot2_nonros/razbot2_model/raspberry_pi/raspberry_pi__USB_x2_part2.SLDPRT

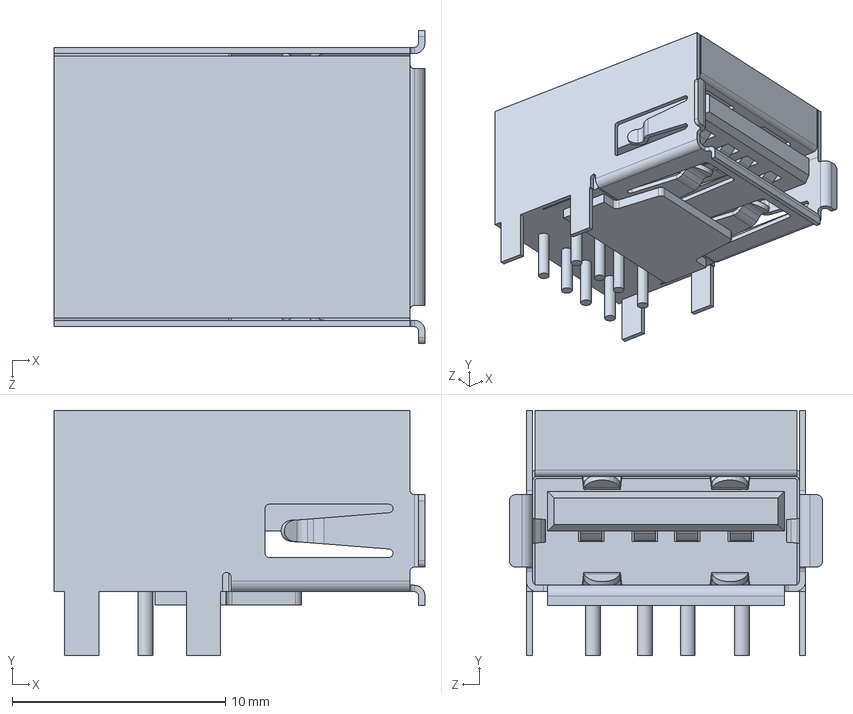
[picture p80: CAD file, 2015-10-27]
razbot2_model/raspberry_pi/raspberry_pi__USB_x2_part2.SLDPRT
17.4 x 11.5 x 14.7 mm
