razbot2/razbot2_nonros/razbot2_model/raspberry_pi/raspberry_pi__SD_reader_body.SLDPRT

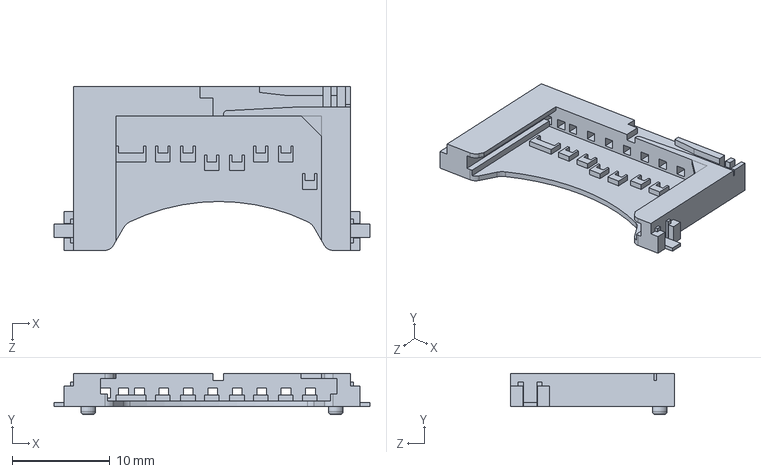
[picture p81: CAD file, 2015-10-27]
razbot2_model/raspberry_pi/raspberry_pi__SD_reader_body.SLDPRT
32.3 x 4.20 x 16.8 mm
