razbot2/razbot2_nonros/razbot2_model/raspberry_pi/raspberry_pi__SD_reader_pin1.SLDPRT

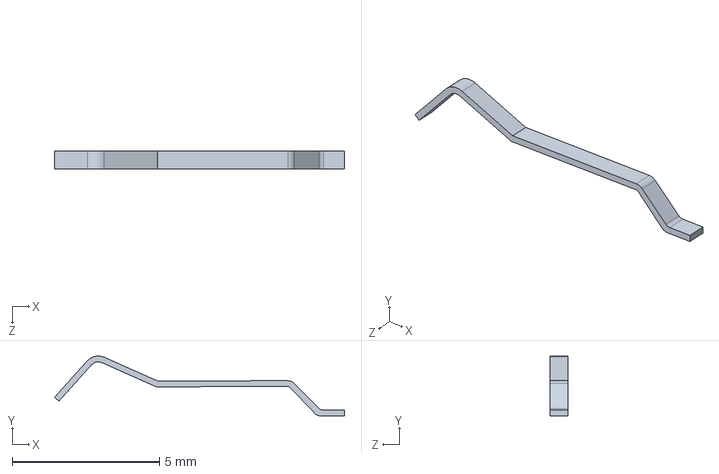
[picture p82: CAD file, 2015-10-27]
razbot2_model/raspberry_pi/raspberry_pi__SD_reader_pin1.SLDPRT
9.85 x 2.04 x 0.6 mm
