razbot2/razbot2_nonros/razbot2_model/raspberry_pi/raspberry_pi__Sot223.SLDPRT

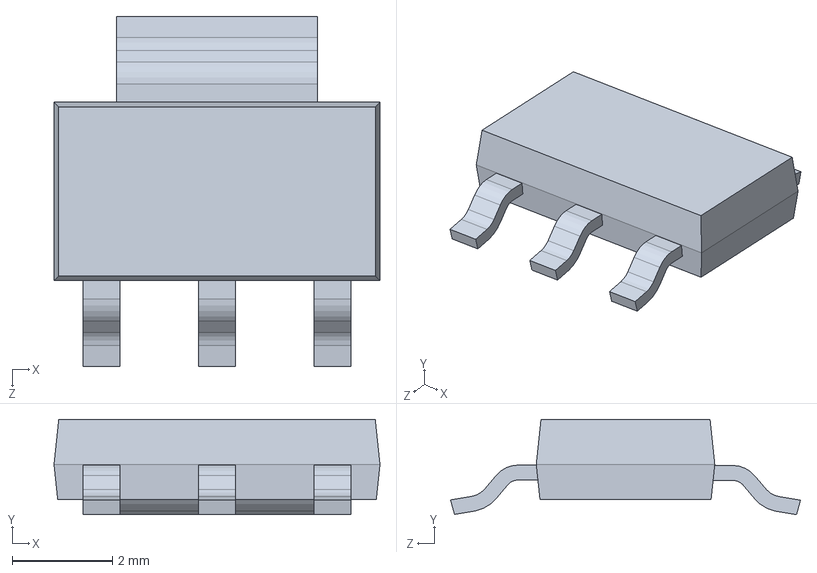
[picture p83: CAD file, 2015-10-27]
razbot2_model/raspberry_pi/raspberry_pi__Sot223.SLDPRT
6.50 x 1.90 x 6.98 mm
