razbot2/razbot2_nonros/razbot2_model/raspberry_pi/raspberry_pi__168_FBGA_12x12.SLDPRT

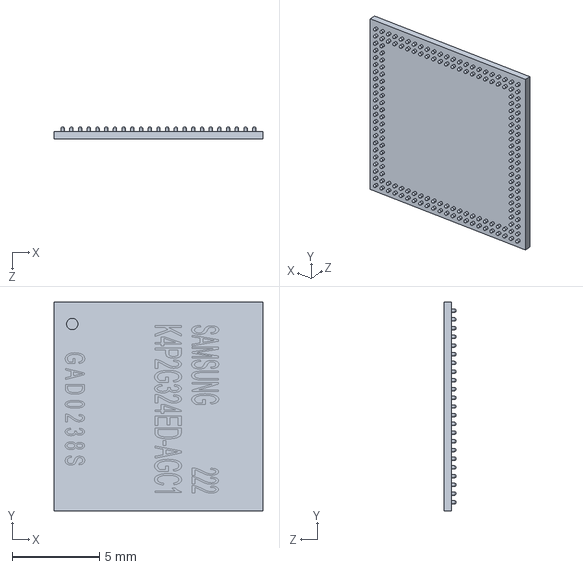
[picture p84: CAD file, 2015-10-27]
razbot2_model/raspberry_pi/raspberry_pi__168_FBGA_12x12.SLDPRT
12.0 x 12.0 x 0.71 mm
