razbot2/razbot2_nonros/razbot2_model/raspberry_pi/raspberry_pi__CI_Board_mounting_holes.SLDPRT

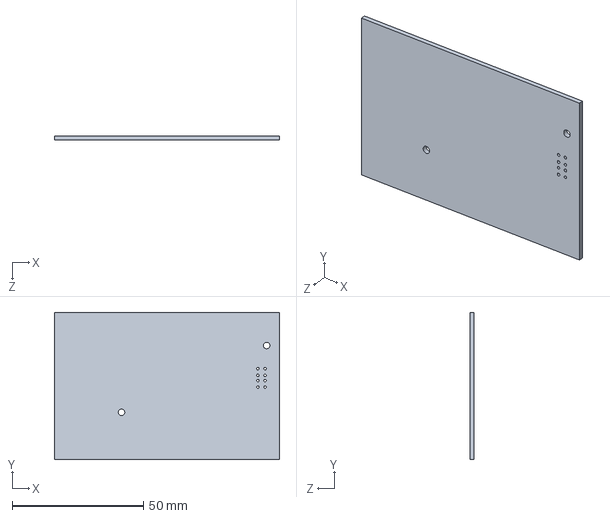
[picture p85: CAD file, 2015-10-27]
razbot2_model/raspberry_pi/raspberry_pi__CI_Board_mounting_holes.SLDPRT
85.6 x 56.0 x 1.60 mm
