razbot2/razbot2_nonros/razbot2_model/raspberry_pi/raspberry_pi__SOD-123_DiodesInc.SLDPRT

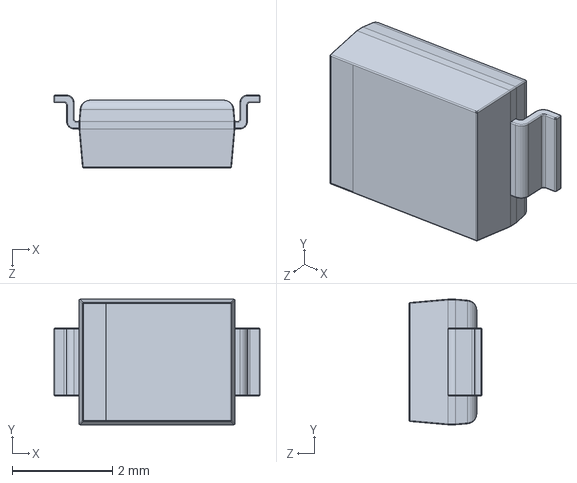
[picture p86: CAD file, 2015-10-27]
razbot2_model/raspberry_pi/raspberry_pi__SOD-123_DiodesInc.SLDPRT
4.10 x 2.50 x 1.45 mm
