razbot2/razbot2_nonros/razbot2_model/raspberry_pi/raspberry_pi__0402.SLDPRT

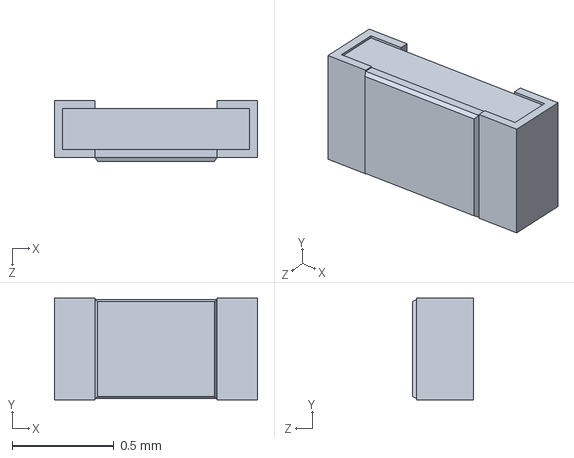
[picture p87: CAD file, 2015-10-27]
razbot2_model/raspberry_pi/raspberry_pi__0402.SLDPRT
1.00 x 0.5 x 0.3 mm
