razbot2/razbot2_nonros/razbot2_model/raspberry_pi/raspberry_pi__Sot23.SLDPRT

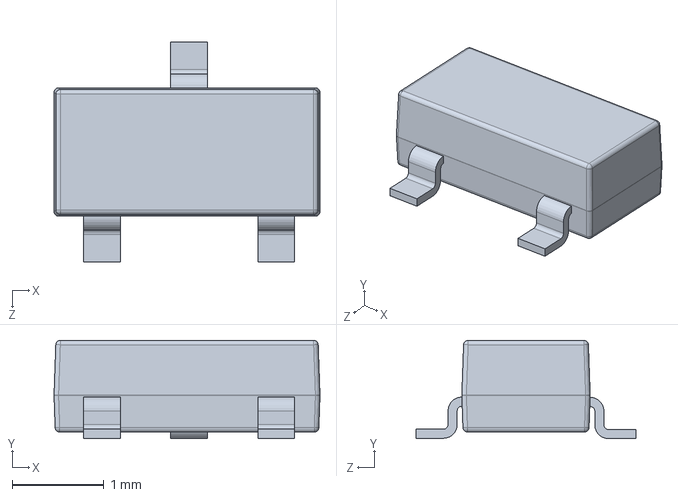
[picture p88: CAD file, 2015-10-27]
razbot2_model/raspberry_pi/raspberry_pi__Sot23.SLDPRT
2.90 x 1.07 x 2.40 mm
