razbot2/razbot2_nonros/razbot2_model/raspberry_pi/raspberry_pi__Smd6.SLDPRT

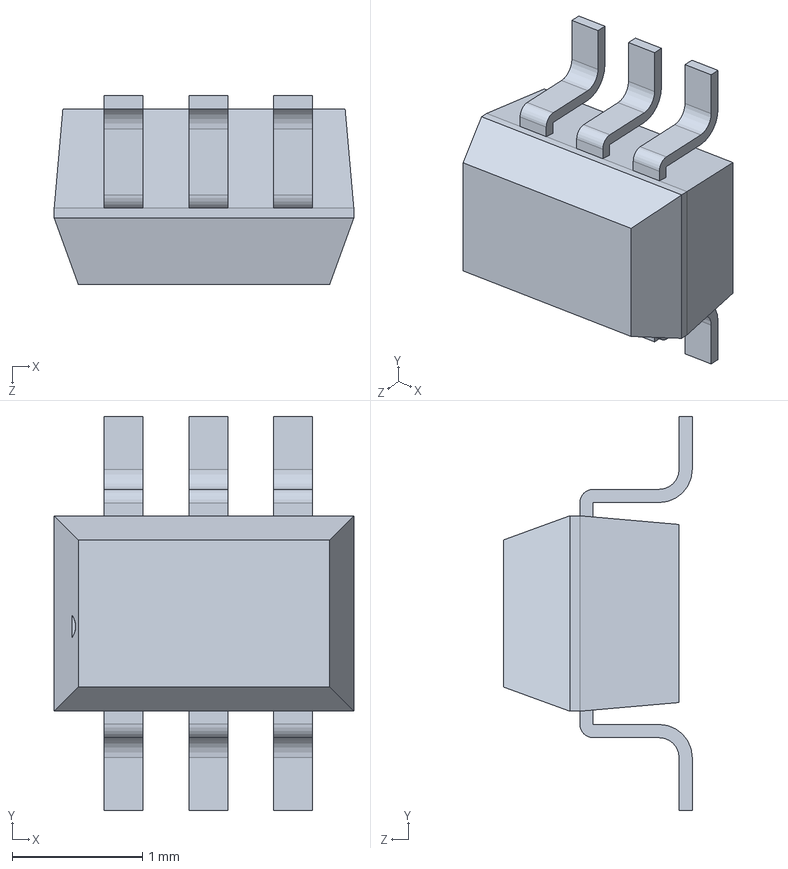
[picture p89: CAD file, 2015-10-27]
razbot2_model/raspberry_pi/raspberry_pi__Smd6.SLDPRT
2.30 x 3.02 x 1.45 mm
