razbot2/razbot2_nonros/razbot2_model/raspberry_pi/raspberry_pi__micro_USB_cover.SLDPRT

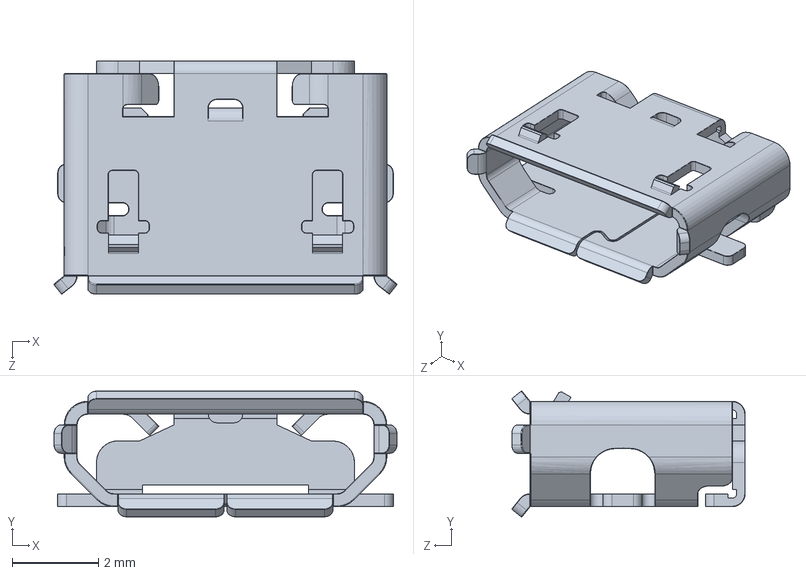
[picture p91: CAD file, 2015-10-27]
razbot2_model/raspberry_pi/raspberry_pi__micro_USB_cover.SLDPRT
7.97 x 2.92 x 5.43 mm
