razbot2/razbot2_nonros/razbot2_model/raspberry_pi/raspberry_pi__1206.SLDPRT

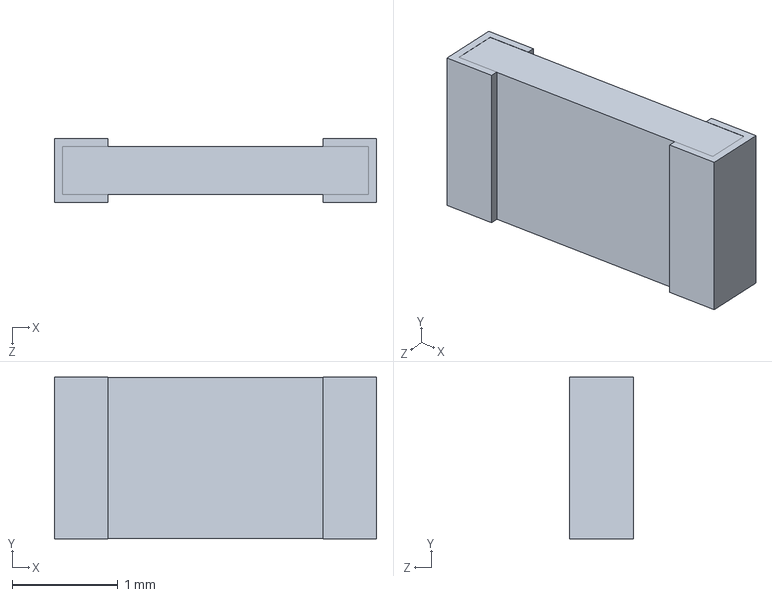
[picture p92: CAD file, 2015-10-27]
razbot2_model/raspberry_pi/raspberry_pi__1206.SLDPRT
3.05 x 1.53 x 0.61 mm
