razbot2/razbot2_nonros/razbot2_model/raspberry_pi/raspberry_pi__bar_180_1x8.SLDPRT

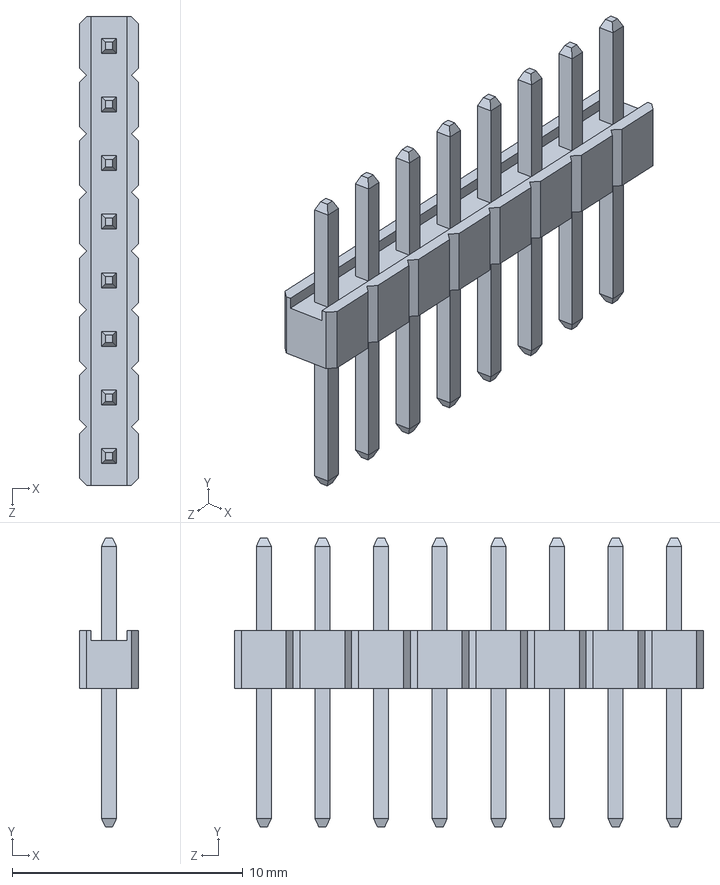
[picture p93: CAD file, 2015-10-27]
razbot2_model/raspberry_pi/raspberry_pi__bar_180_1x8.SLDPRT
2.54 x 12.5 x 20.3 mm
