razbot2/razbot2_nonros/razbot2_model/raspberry_pi/raspberry_pi__Xtal_Smd_19200.SLDPRT

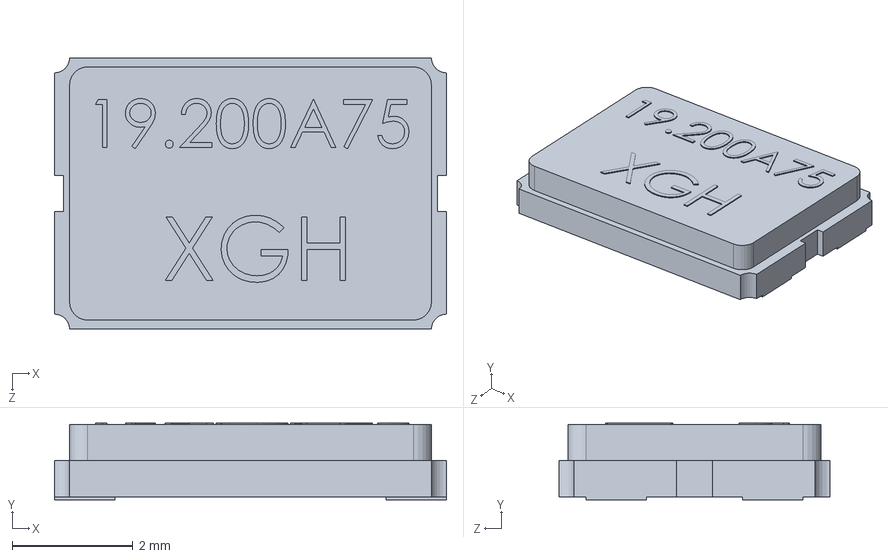
[picture p94: CAD file, 2015-10-27]
razbot2_model/raspberry_pi/raspberry_pi__Xtal_Smd_19200.SLDPRT
6.50 x 1.27 x 4.50 mm
