razbot2/razbot2_nonros/razbot2_model/raspberry_pi/raspberry_pi__SD Card.SLDPRT

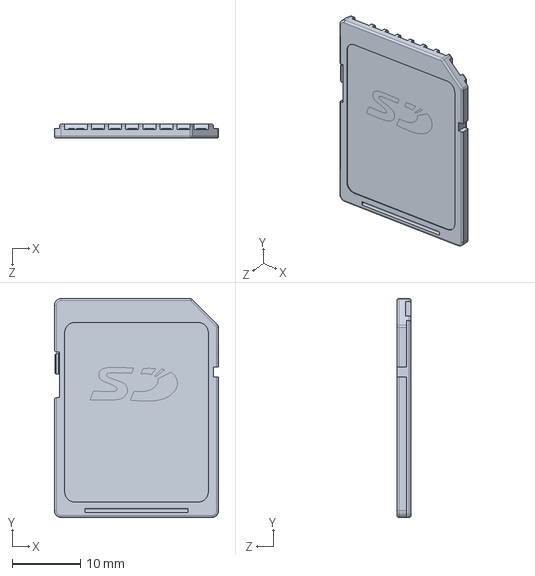
[picture p95: CAD file, 2015-10-27]
razbot2_model/raspberry_pi/raspberry_pi__SD Card.SLDPRT
24.0 x 32.0 x 2.10 mm
