razbot2/razbot2_nonros/razbot2_model/raspberry_pi/raspberry_pi__SD_reader_pin3.SLDPRT

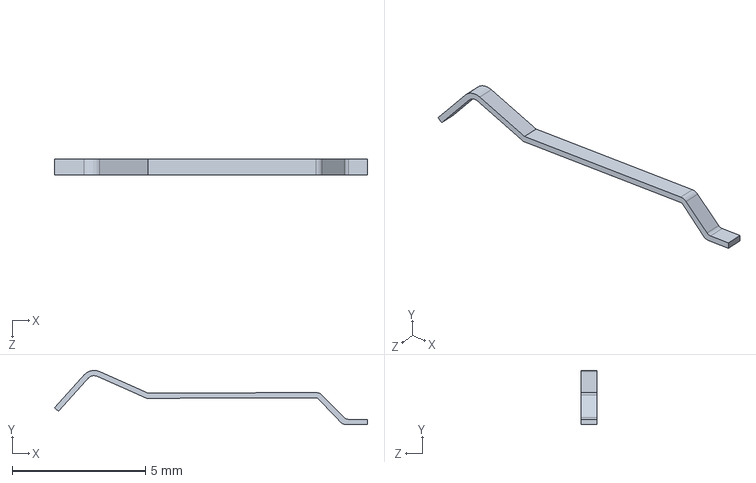
[picture p96: CAD file, 2015-10-27]
razbot2_model/raspberry_pi/raspberry_pi__SD_reader_pin3.SLDPRT
11.7 x 2.03 x 0.6 mm
