razbot2/razbot2_nonros/razbot2_model/raspberry_pi/raspberry_pi__sot-223_large.SLDPRT

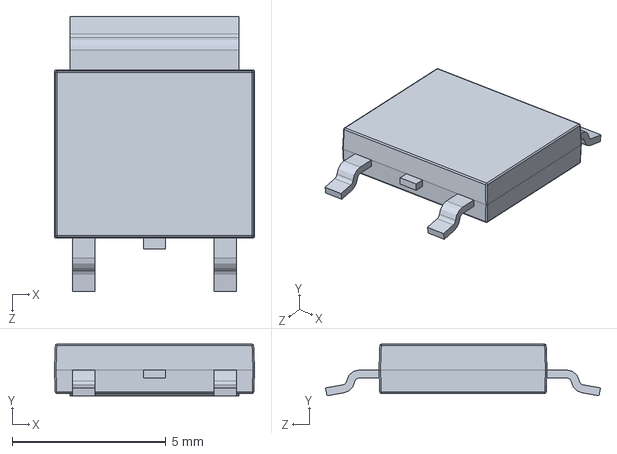
[picture p97: CAD file, 2015-10-27]
razbot2_model/raspberry_pi/raspberry_pi__sot-223_large.SLDPRT
6.50 x 1.67 x 8.93 mm
