razbot2/razbot2_nonros/razbot2_model/raspberry_pi/raspberry_pi__0603.SLDPRT

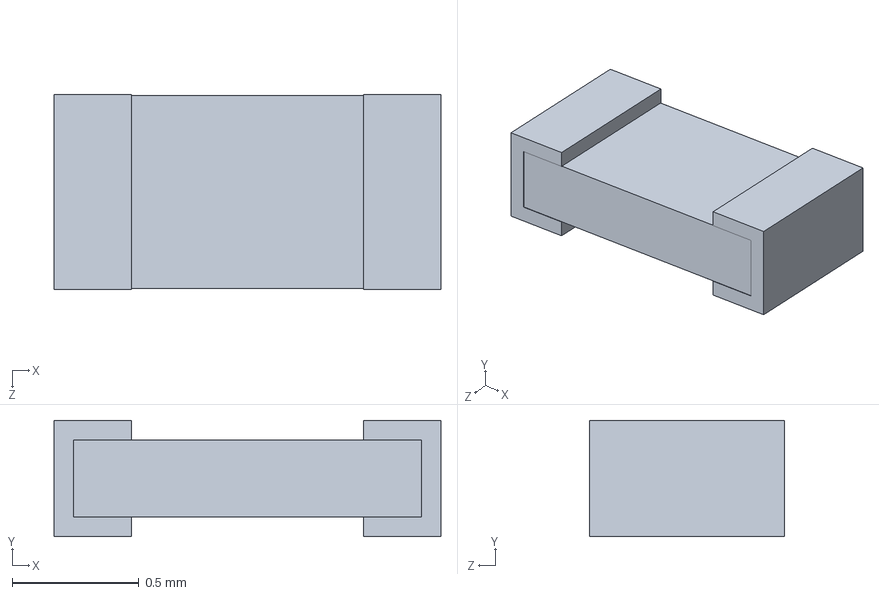
[picture p98: CAD file, 2015-10-27]
razbot2_model/raspberry_pi/raspberry_pi__0603.SLDPRT
1.52 x 0.457 x 0.767 mm
