razbot2/razbot2_nonros/razbot2_model/raspberry_pi/raspberry_pi__15_pin_FFC_Connector_body.SLDPRT

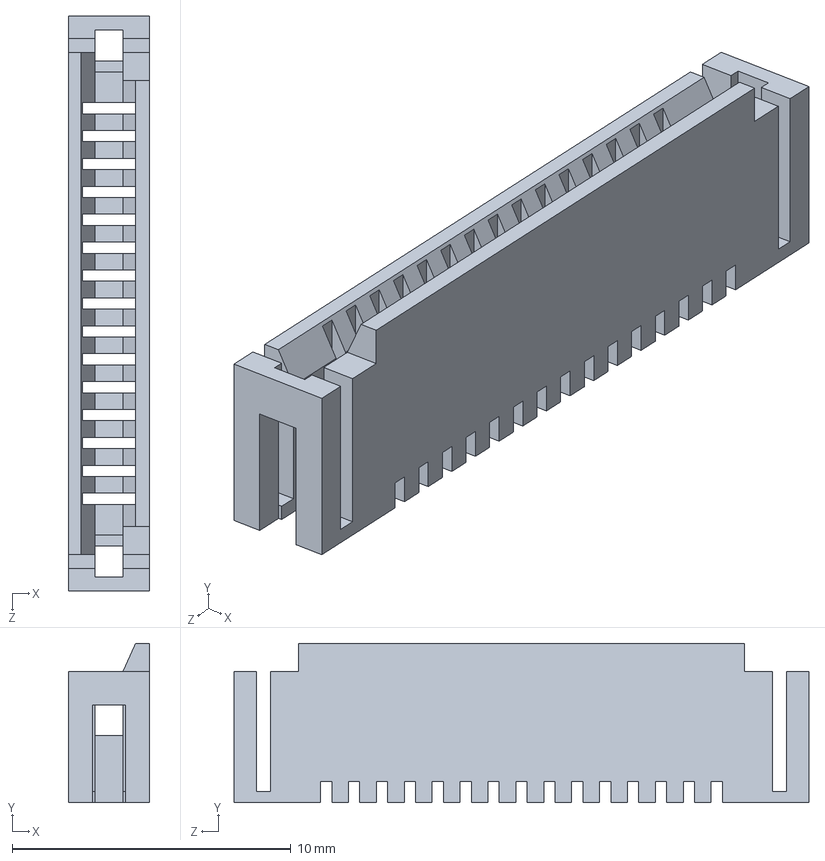
[picture p99: CAD file, 2015-10-27]
razbot2_model/raspberry_pi/raspberry_pi__15_pin_FFC_Connector_body.SLDPRT
2.90 x 5.70 x 20.6 mm
