razbot2/razbot2_nonros/razbot2_model/raspberry_pi/raspberry_pi__15_pin_FFC_Connector_locker.SLDPRT

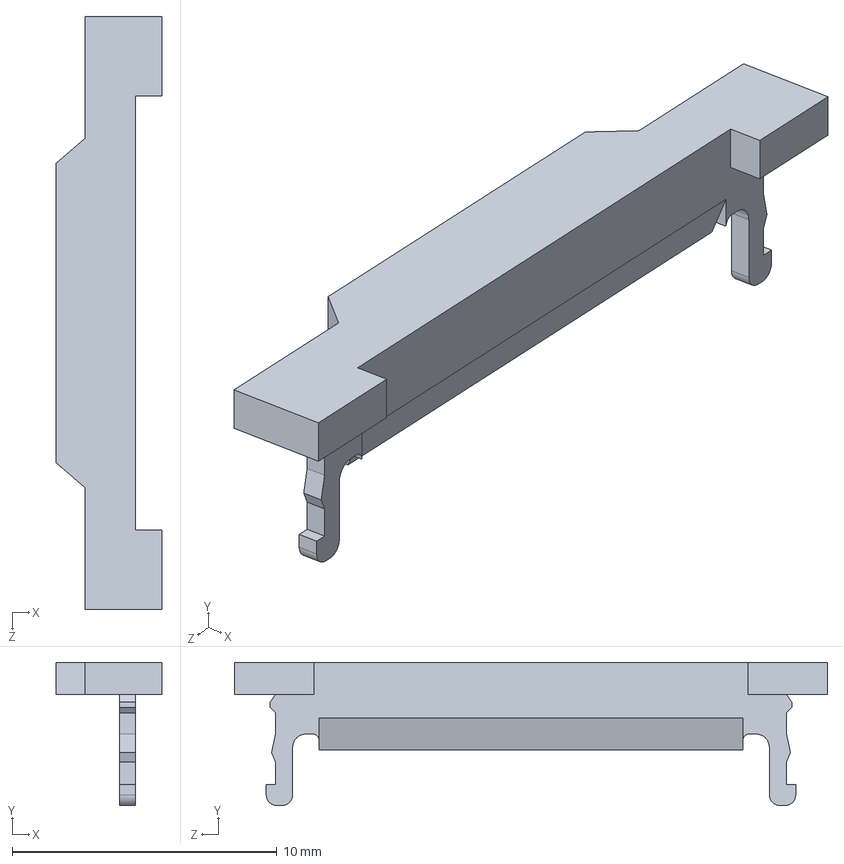
[picture p100: CAD file, 2015-10-27]
razbot2_model/raspberry_pi/raspberry_pi__15_pin_FFC_Connector_locker.SLDPRT
4.00 x 5.40 x 22.4 mm
