razbot2/razbot2_nonros/razbot2_model/raspberry_pi/raspberry_pi__bar_180_2x13.SLDPRT

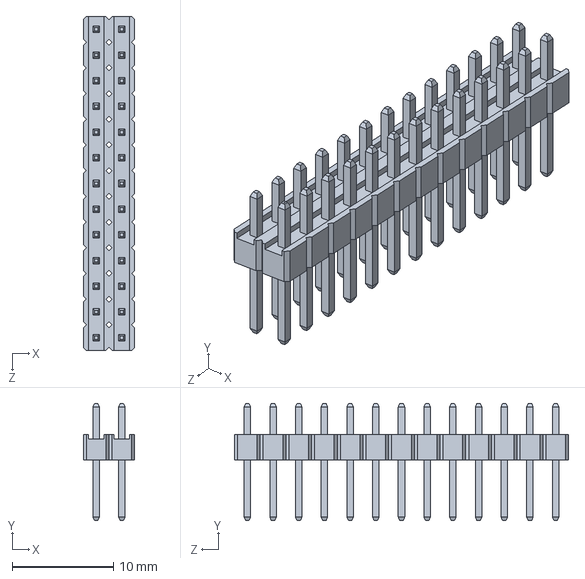
[picture p101: CAD file, 2015-10-27]
razbot2_model/raspberry_pi/raspberry_pi__bar_180_2x13.SLDPRT
5.08 x 11.6 x 33.0 mm
