razbot2/razbot2_nonros/razbot2_model/raspberry_pi/raspberry_pi__1206xl.SLDPRT

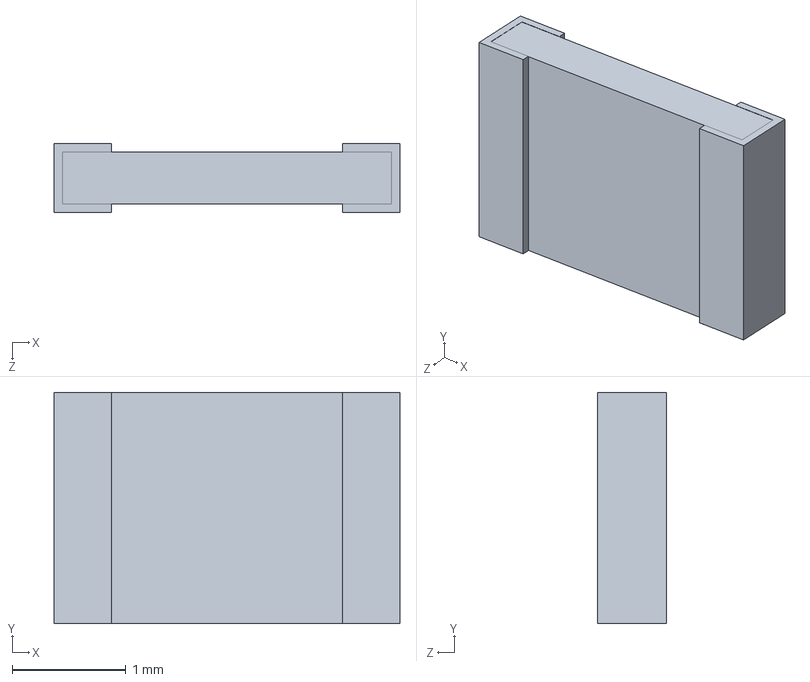
[picture p102: CAD file, 2015-10-27]
razbot2_model/raspberry_pi/raspberry_pi__1206xl.SLDPRT
3.05 x 2.04 x 0.61 mm
