razbot2/razbot2_nonros/razbot2_model/raspberry_pi/raspberry_pi__composite_video_out.SLDPRT

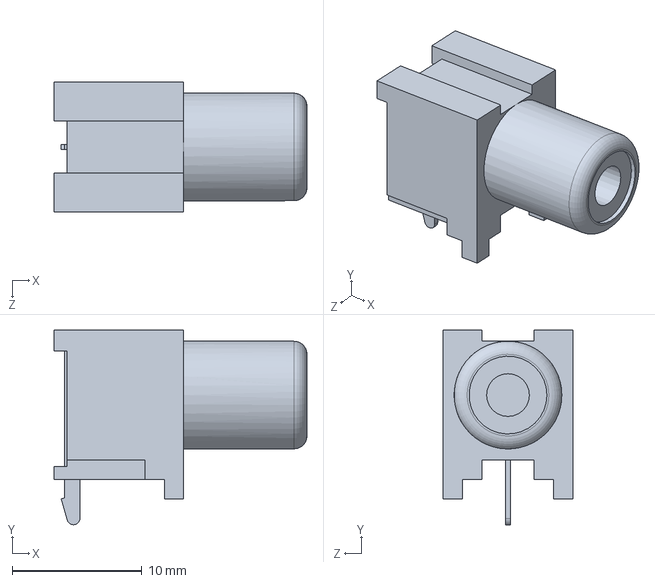
[picture p103: CAD file, 2015-10-27]
razbot2_model/raspberry_pi/raspberry_pi__composite_video_out.SLDPRT
19.5 x 15.0 x 10.0 mm
