razbot2/razbot2_nonros/razbot2_model/raspberry_pi/raspberry_pi__SD_reader_pin2.SLDPRT

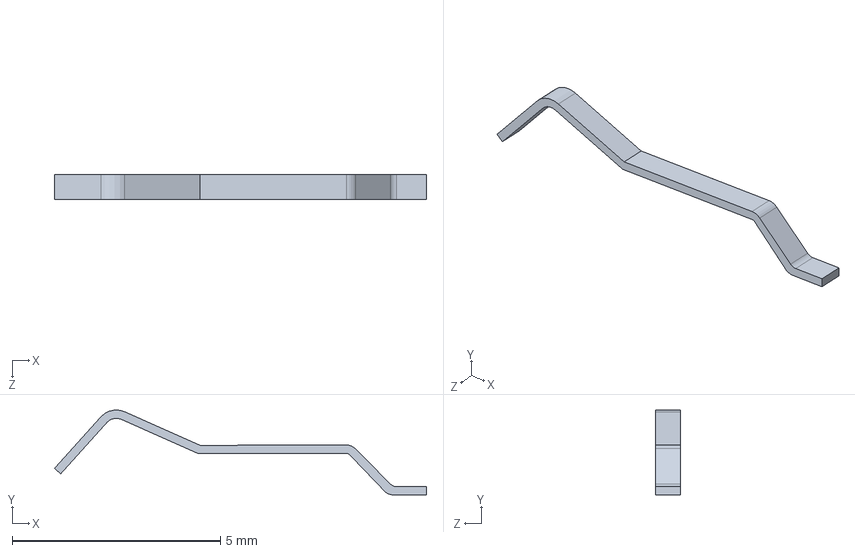
[picture p104: CAD file, 2015-10-27]
razbot2_model/raspberry_pi/raspberry_pi__SD_reader_pin2.SLDPRT
8.94 x 2.04 x 0.6 mm
