razbot2/razbot2_nonros/razbot2_model/raspberry_pi/raspberry_pi__USB_x2_part1.SLDPRT

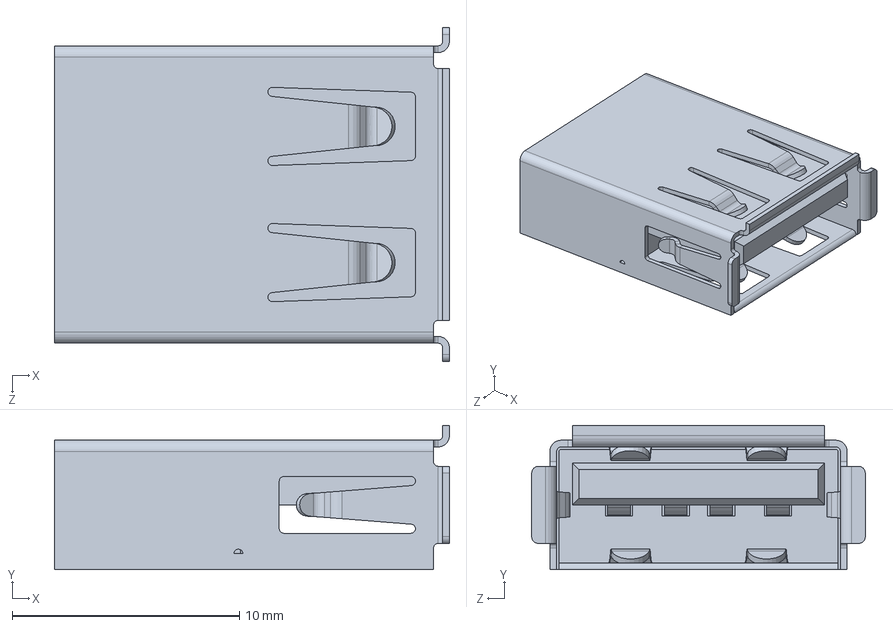
[picture p105: CAD file, 2015-10-27]
razbot2_model/raspberry_pi/raspberry_pi__USB_x2_part1.SLDPRT
17.4 x 6.35 x 14.7 mm
