razbot2/razbot2_nonros/razbot2_model/raspberry_pi/raspberry_pi__SD_reader_pin5.SLDPRT

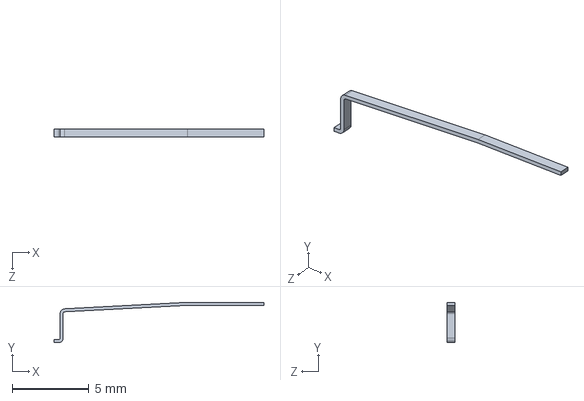
[picture p106: CAD file, 2015-10-27]
razbot2_model/raspberry_pi/raspberry_pi__SD_reader_pin5.SLDPRT
13.7 x 2.63 x 0.55 mm
