razbot2/razbot2_nonros/razbot2_model/raspberry_pi/raspberry_pi__capacitor_smd.SLDPRT

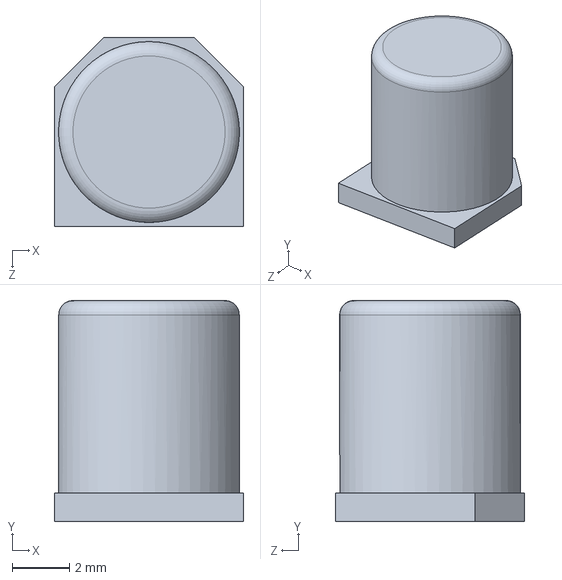
[picture p107: CAD file, 2015-10-27]
razbot2_model/raspberry_pi/raspberry_pi__capacitor_smd.SLDPRT
6.60 x 7.70 x 6.60 mm
