razbot2/razbot2_nonros/razbot2_model/raspberry_pi/raspberry_pi__HDMI_socket_inside.SLDPRT

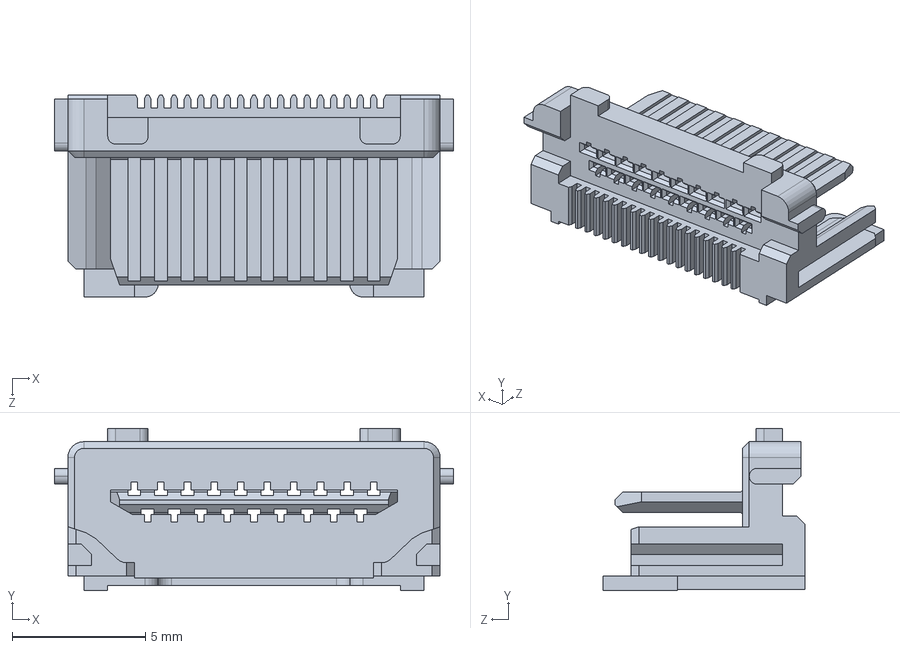
[picture p108: CAD file, 2015-10-27]
razbot2_model/raspberry_pi/raspberry_pi__HDMI_socket_inside.SLDPRT
15.0 x 6.10 x 7.60 mm
