razbot2/razbot2_nonros/razbot2_model/raspberry_pi/raspberry_pi__Sot23-3_5pins.SLDPRT

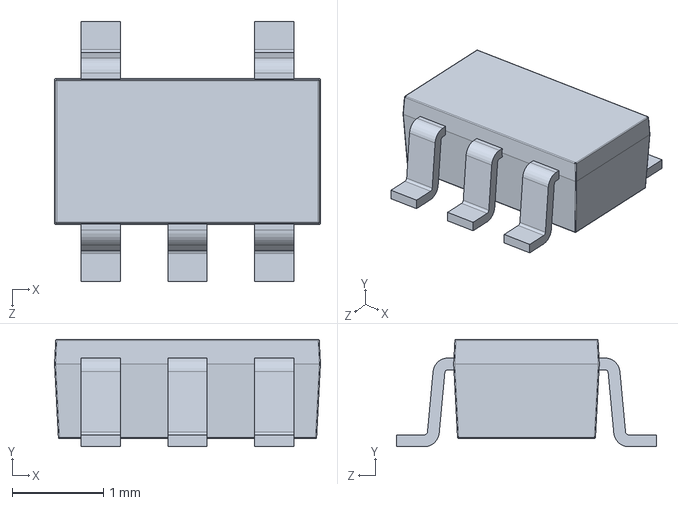
[picture p109: CAD file, 2015-10-27]
razbot2_model/raspberry_pi/raspberry_pi__Sot23-3_5pins.SLDPRT
2.92 x 1.18 x 2.85 mm
