razbot2/razbot2_nonros/razbot2_model/raspberry_pi/raspberry_pi__RJ45.SLDPRT

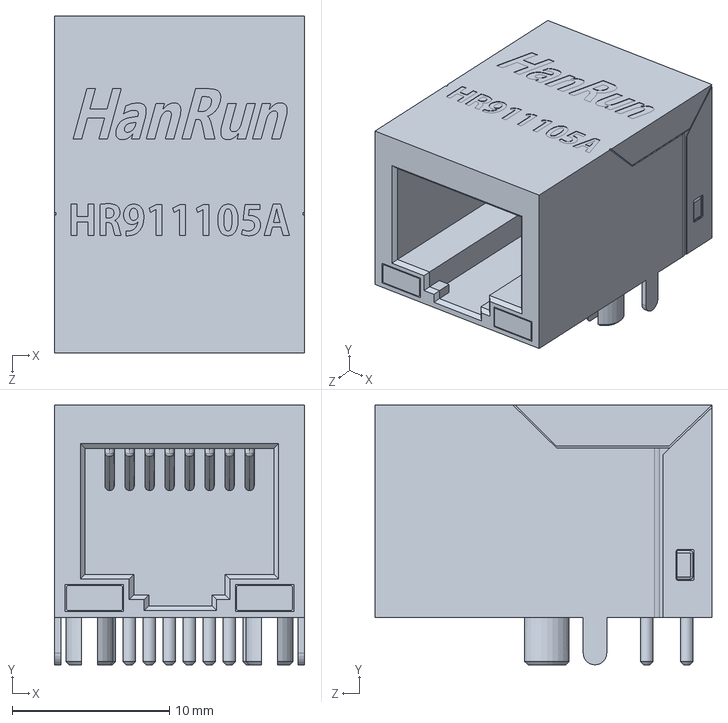
[picture p110: CAD file, 2015-10-27]
razbot2_model/raspberry_pi/raspberry_pi__RJ45.SLDPRT
15.9 x 16.5 x 21.4 mm
