razbot2/razbot2_nonros/(list of files, cad)

Other CAD files:
razbot2_model/razbot_STL/RR_motor_holder.STL
razbot2_model/wheel_3.SLDPRT
razbot2_model/razbot_STL/PiTrayB+.STL
razbot2_model/razbot_STL/wheel.STL
razbot2_model/Top_Plate.SLDPRT
razbot2_model/motor_holder_fr0.6.SLDPRT
razbot2_model/motor_holder_r0.4.SLDPRT
razbot2_model/raspberry_pi/raspberry_pi__Xtal_Smd_25.SLDPRT
razbot2_model/PiTrayB.SLDPRT
razbot2_model/raspberry_pi_camera/OVA5647.SLDPRT
razbot2_model/razbot_STL/PiTrayB.STL
