razbot2/razbot2_nonros/razbot2_documentation/assembly_pictures/IMG_3686.JPG

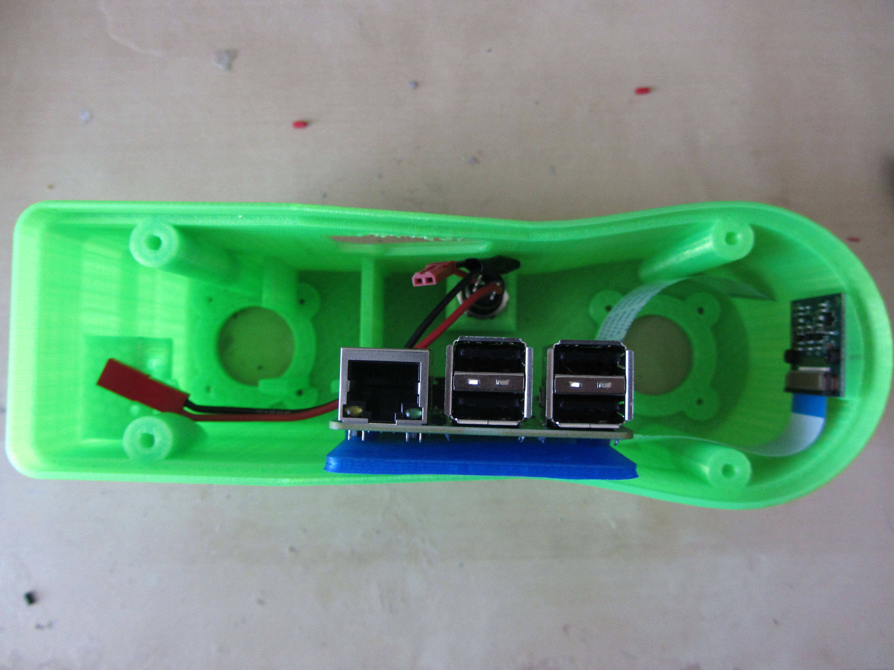
razbot2_documentation/assembly_pictures/IMG_3686.JPG
