razbot2/razbot2_nonros/razbot2_documentation/razbot2_guide/diagram/pcbv2.png

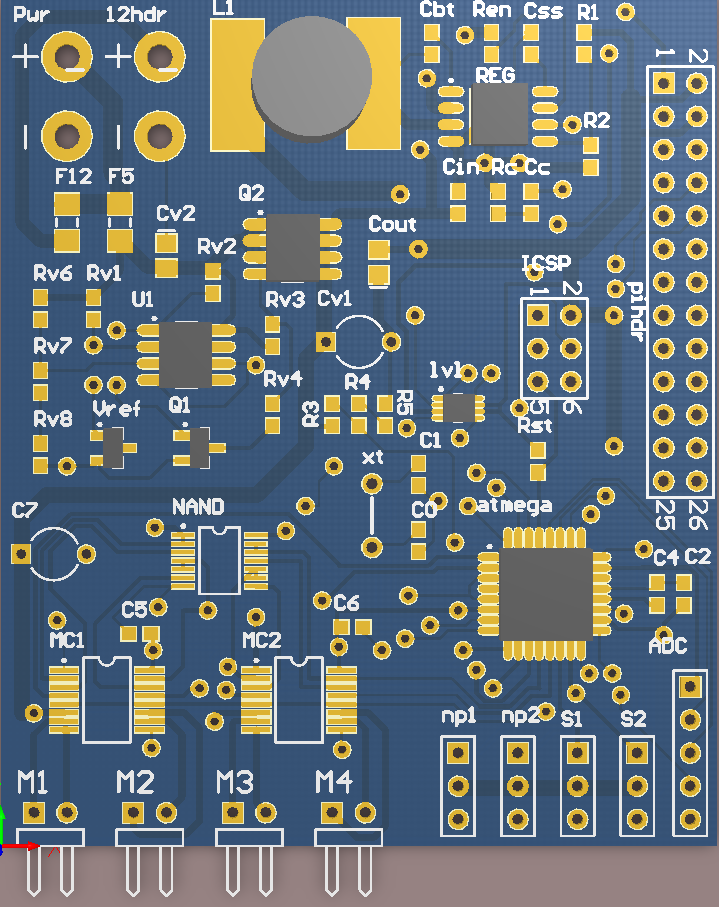
razbot2_documentation/razbot2_guide/diagram/pcbv2.png
