razbot2/razbot2_nonros/razbot2_documentation/razbot2_guide/diagram/razbotsize.jpg

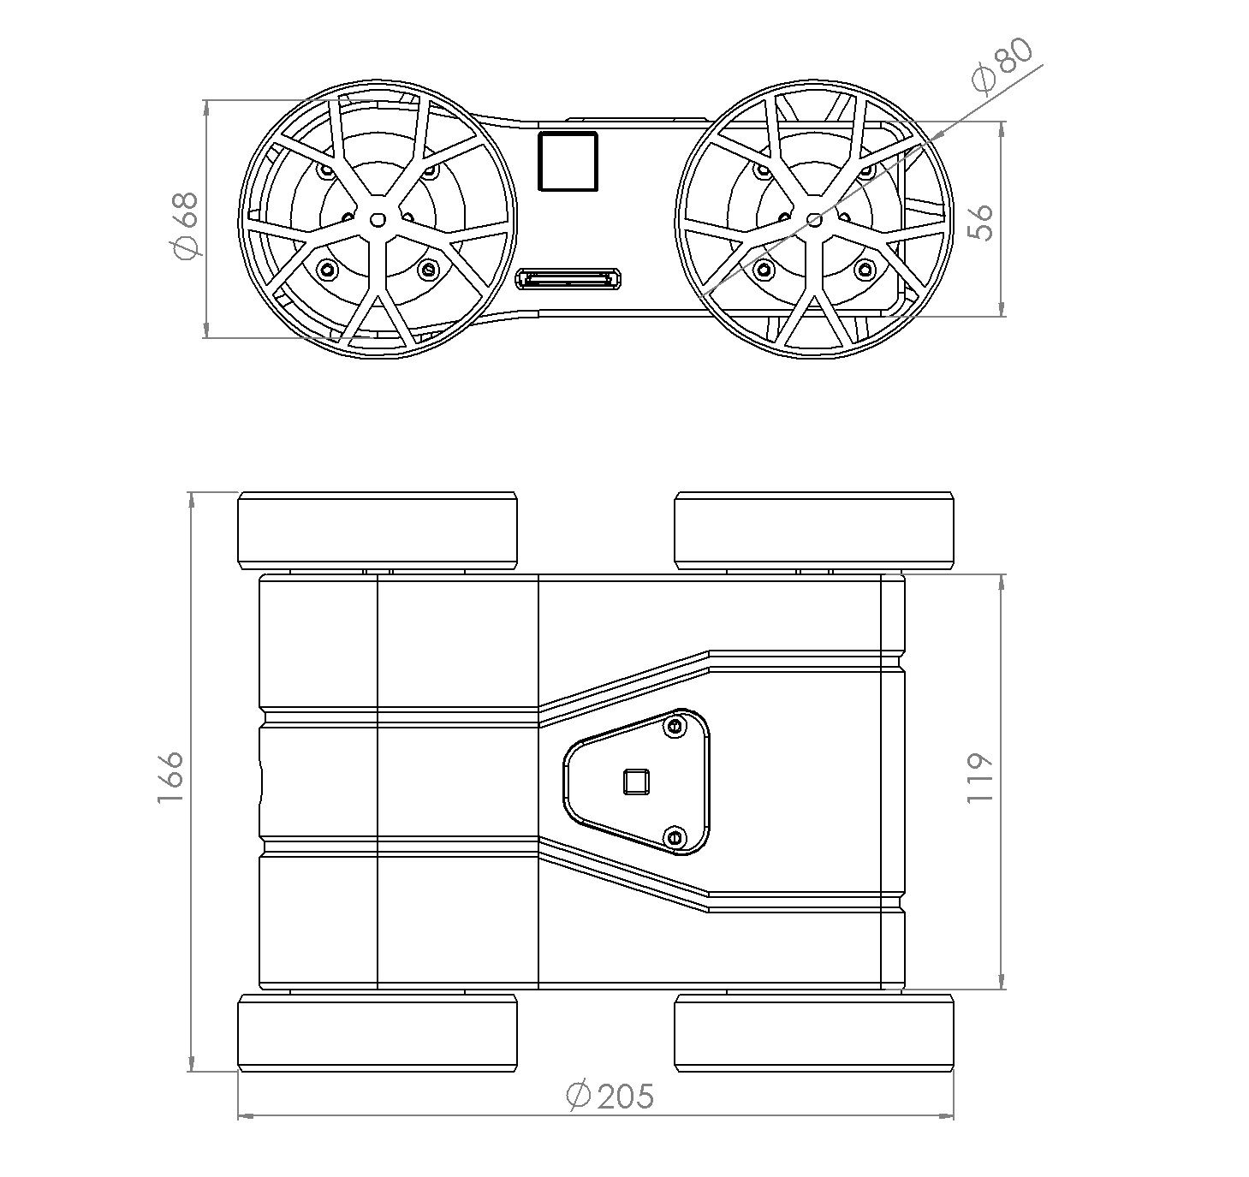
razbot2_documentation/razbot2_guide/diagram/razbotsize.jpg
