razbot2/razbot2_nonros/razbot2_documentation/razbot2_guide/render/pbf.jpg

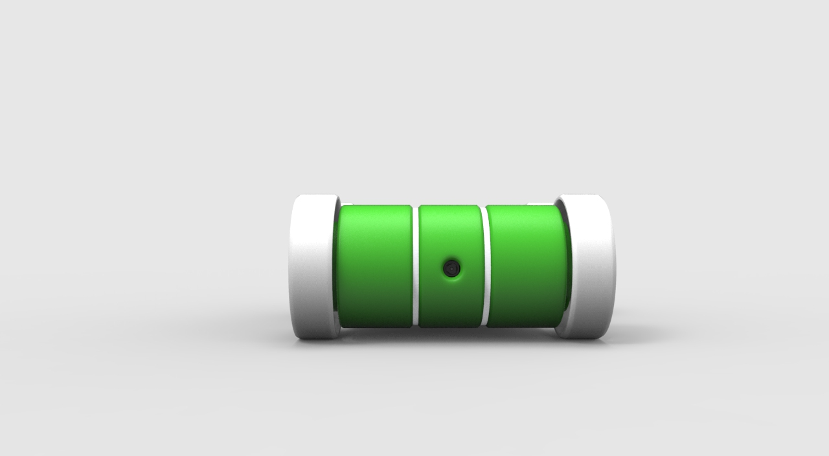
razbot2_documentation/razbot2_guide/render/pbf.jpg
