razbot2/razbot2_nonros/razbot2_documentation/razbot2_guide/render/pbs2.jpg

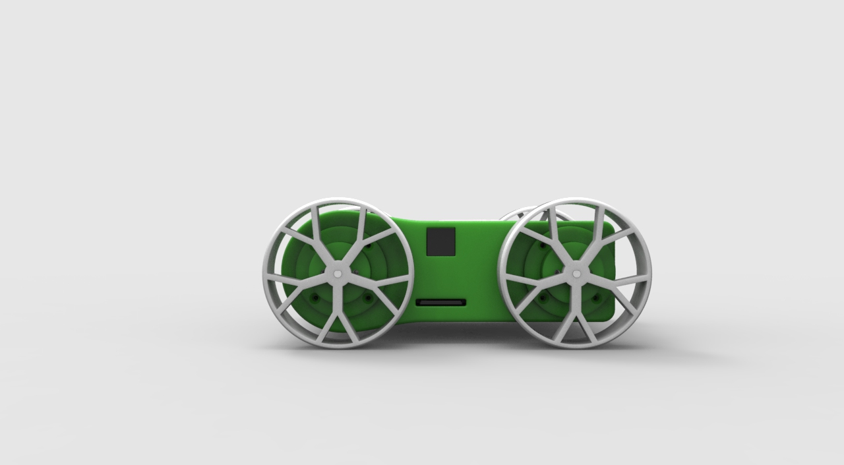
razbot2_documentation/razbot2_guide/render/pbs2.jpg
