razbot2/razbot2_nonros/razbot2_documentation/razbot2_guide/render/PibotKeyshot.10.jpg

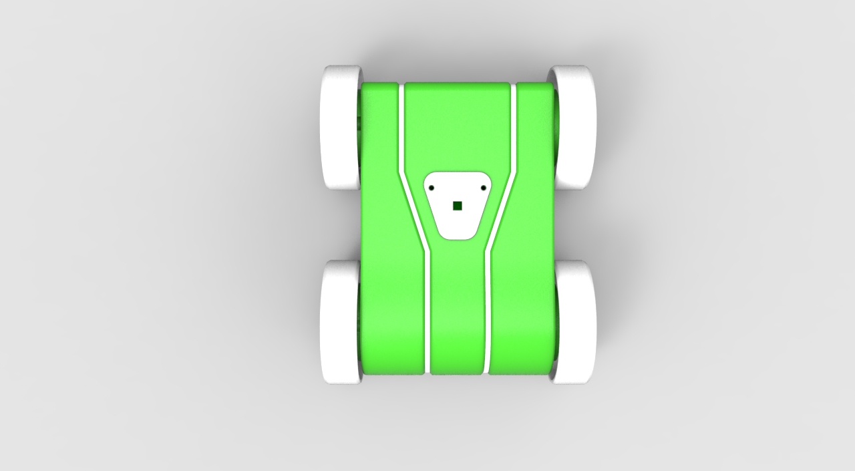
razbot2_documentation/razbot2_guide/render/PibotKeyshot.10.jpg
