razbot2/razbot2_nonros/razbot2-core/mjpg-streamer/plugins/input_testpicture/pictures/160x120_1.jpg

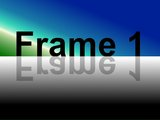
razbot2-core/mjpg-streamer/plugins/input_testpicture/pictures/160x120_1.jpg
