razbot2/razbot2_nonros/(list of files, drawings)

Other design files:
razbot2_electronics/_archive/Altium Pibot V01/History/MotorDriverL298.SchDoc
razbot2_electronics/_archive/Altium Pibot V01/History/RpiPaw1_Sch.SchDoc
razbot2_electronics/_archive/Altium Pibot V01/MotorDriverL298 (REs3's conflicted copy 2014-10-09).SchDoc
razbot2_electronics/_archive/Altium Pibot V01/MotorDriverL298.SchDoc
razbot2_electronics/_archive/Altium Pibot V01/MotorDriverToshiba.SchDoc
razbot2_electronics/_archive/Altium Pibot V01/Paw2.PcbDoc
razbot2_electronics/_archive/Altium Pibot V01/Paw3.PcbDoc
razbot2_electronics/_archive/Altium Pibot V01/paw4.PcbDoc
razbot2_electronics/_archive/Altium Pibot V01/paw5.PcbDoc
razbot2_electronics/_archive/Altium Pibot V01/paw6.PcbDoc
razbot2_electronics/_archive/Altium Pibot V01/paw7.PcbDoc
razbot2_electronics/_archive/Altium Pibot V01/paw8.PcbDoc
razbot2_electronics/_archive/Altium Pibot V01/Paw_Back.PcbDoc
razbot2_electronics/_archive/Altium Pibot V01/PawPcbLib1.PcbLib
razbot2_electronics/_archive/Altium Pibot V01/PwrSupply.SchDoc
razbot2_electronics/_archive/Altium Pibot V01/RpiPaw1.PrjPCB
razbot2_electronics/_archive/Altium Pibot V01/RpiPaw1_Sch.SchDoc
razbot2_electronics/_archive/Altium Pibot V01/RpiPaw1_SchLib.SchLib
razbot2_electronics/altium razbot/History/razbot_V02.~(64).PcbDoc
razbot2_electronics/altium razbot/History/razbot_V02.~(65).PcbDoc
razbot2_electronics/altium razbot/razbot.PrjPCB
razbot2_electronics/altium razbot/razbot.SchDoc
razbot2_electronics/altium razbot/razbot_SchLib.SchLib
razbot2_electronics/altium razbot/razbot_V01.PcbDoc
razbot2_electronics/altium razbot/razbot_V02.PcbDoc
razbot2_electronics/altium razbot/razbotLowVoltageProt.SchDoc
razbot2_electronics/altium razbot/razbotMotorDriverToshiba.SchDoc
razbot2_electronics/altium razbot/razbotPcbLib1.PcbLib
razbot2_electronics/altium razbot/razbotPwrSupply.SchDoc
